benoit-bremaud/cubbies/docs/hardware/calculations/README.md

# Calculations and simulations — cubbies V1

Every figure that chooses or checks a component is recorded here, so that it can be found again
and recomputed. The method is the one proven on V-SEA (owner decision 2026-10-15), scaled to a
hand-wired cube with no PCB.

- [`log.md`](log.md) is the chronological log. **It is append only.** A corrected or superseded
  result goes in a new entry that cites the one it replaces. A merged entry is never edited.
- Each entry `C-NNNN` records:
  - **Purpose**, with its criticality tier;
  - **Method**;
  - **Inputs**, each with its source or marked ASSUMED;
  - **Result**;
  - **Used in**;
  - **Reproduce**, the command that recomputes it;
  - **Based on**, the `main` commit it was computed from.
- A figure used without an entry is not finished. The PR that uses the figure adds the entry.

## Tools

- **Simulation: ngspice 42 benches** in
  [`hardware/electronics/sim/`](../../../hardware/electronics/sim/), one `.cir` per block.
  - Each bench opens with a header stating what it validates, its assumptions, the PASS
    criterion and its run command.
  - Corners are swept with `foreach` / `alterparam`. They are worst-case corners (source ×
    tolerance × load), not Monte Carlo.
  - Where a protection is claimed, the bench adds a negative control (the circuit without it).
  - `sh run.sh` reruns every bench and writes the result tables and SVG plots to `results/`.
- **Arithmetic: `calc.py`** holds the tier-3 lines and needs no dependencies.
- **Second method: `crosscheck.py`** recomputes every Tier 1 bench corner from closed-form or
  piecewise-exact equations and fails on a disagreement (C-0015; owner MCDA 410/500 against a
  second SPICE engine). `run.sh` runs it after the benches.
- **Models: `models.lib`** holds generic models fitted to datasheet worst-case limits. No vendor
  model is redistributed.

R and C nominal values come from `hardware/electronics/cubbies-v1.kicad_sch` through
`sim/schematic.lib`, generated by `schematic_values.py` (as V-SEA does with `spice_block.py`);
`run.sh` refreshes it when kicad-cli is installed. Tolerances, corners, module pull-ups and the
diode, MOSFET and buzzer models stay in each bench.

## Criticality tiers

Each entry states its tier in its Purpose.

| Tier | Applies to | Depth of verification |
|---|---|---|
| 1, critical | Boot or reset correctness, or a datasheet requirement met with less than 2× margin | Theory, then a SPICE bench with full corners, then a second method: closed-form recomputation of every corner (`crosscheck.py`, C-0015; owner MCDA 410/500 over a second SPICE engine). |
| 2, important | A datasheet requirement met with at least 2× margin | Theory plus one SPICE point, or only the corners a decision needs |
| 3, routine | A wide margin | The calculation line alone |

## Status per block

`draft` → `simulated` → `measured` → `approved` (approval at the CDR, `gates.md`).

| Block | Entries | Status |
|---|---|---|
| Current budget, 3V3 LDO | C-0001, C-0013 (supersedes C-0002), C-0012 | calculated from the XC6210 datasheet; θJA bounded 132–400 °C/W, bench temperature at 50 mA on J1 open (CDR) |
| Buzzer stage | C-0003, C-0004, C-0005, C-0015 | simulated, second method agrees on C-0003 |
| Display RESET RC | C-0006, C-0015 | simulated, second method agrees (cold-boot bench open) |
| I2C bus | C-0007, C-0015 | simulated, second method agrees (bench rise-time measurement open) |
| Strapping pins | C-0008, C-0014, C-0015 | simulated, second method agrees (bench boot check open) |
| INMP441, TTP223, SSD1331 interfaces | C-0009, C-0010, C-0011 | calculated |
| V2 battery | — | not started (ADR-0002) |
