benoit-bremaud/cubbies/docs/architecture/traceability-matrix.md

# Traceability matrix — cubbies V1

Proves coverage: every requirement has a use case, a design view, a component and a
verification; nothing is orphaned. This file owns the REQ → design → verification mapping; the
use cases own UC → REQ. Updated at each PDR. Port and module names follow the component diagram
of the first UML study (`diagrams/cube-core/03-component.md`, merged in PR #5).

| Requirement | Use case(s) | Sequence / state | Component (port) | Verification |
|---|---|---|---|---|
| REQ-F-01 eyes | UC3, UC5 | [05a-state-mood-engine](diagrams/cube-core/05a-state-mood-engine.md) (reactions) | eye renderer → `IDisplay` (mood frame, reaction overlay, identity frames; `Timeline`) | golden images (39 frames), blink period test, reaction timing tests (F1b) |
| REQ-F-02 moods | UC3, UC4, UC8 | [05a-state-mood-engine](diagrams/cube-core/05a-state-mood-engine.md) | mood engine (`MoodEngine`); stimulus router (`route`, `effects`) | native mood tests (05a rows), router tests, golden images (F2) |
| REQ-F-03 touch gestures | UC1, UC3, UC6 | [05c-state-gesture-classifier](diagrams/cube-core/05c-state-gesture-classifier.md) | gesture classifier (touch-down + classified gestures) ← `ITouchSource`; eye renderer `TouchDown` overlay held until release | native gesture tests, bench; touch-down next-tick test (F1b) |
| REQ-F-04 sounds | UC3, UC5, UC7 | [05e-state-sound-gate](diagrams/cube-core/05e-state-sound-gate.md) | note tables + `SoundGate` → `IAudio` (notes, level) | native gate tests (F2), bench, ngspice `buzzer-driver.cir` (C-0003..C-0005, ADR-0015 D3) |
| REQ-F-05 volume, silence | UC6 (V1.x ritual step), B1 | [05b-state-sleep-wake](diagrams/cube-core/05b-state-sleep-wake.md), [05e-state-sound-gate](diagrams/cube-core/05e-state-sound-gate.md) | `SoundGate` in `lib/` → `IAudio` (constant `kVolume`, muted Dozing/Asleep) | native gate tests, `RecordingAudio` (F2) |
| REQ-F-06 sleep / wake | UC5 | [05b-state-sleep-wake](diagrams/cube-core/05b-state-sleep-wake.md) | `SleepCycle` ← `IClock` (uptime), reads `MoodEngine` | native sleep tests with injected clock (05b rows, F2) |
| REQ-F-07 identity default + ritual | UC1 | [02a-first-boot](diagrams/identity/02a-sequence-first-boot.md), [02b-adoption](diagrams/identity/02b-sequence-adoption-ritual.md), [05a-invitation](diagrams/identity/05a-state-invitation-window.md), [05b-ritual](diagrams/identity/05b-state-adoption-ritual.md) | identity rules ← `IStorage`, MAC passed by value (`resolveIdentity`, `InvitationWindow`, `AdoptionRitual`, F3); eye renderer identity frames (invitation, ritual, adoption, error) | native tests (`test_native_identity`, `test_native_invitation`, `test_native_ritual`, F3), bench; identity-frame goldens (F1b) |
| REQ-F-08 identity persistence | UC1 | [02a-first-boot](diagrams/identity/02a-sequence-first-boot.md), [05b-ritual](diagrams/identity/05b-state-adoption-ritual.md) | `IStorage` (typed `readU8`/`writeU8`, NVS adapter `NvsStorage`, F5) | native tests (stored/missing/out-of-range, single write, fail closed), bench ([bench-f5](../hardware/bench-f5.md) #8) |
| REQ-F-09 sound reactions | UC4, UC5 | [05d-state-sound-classifier](diagrams/cube-core/05d-state-sound-classifier.md) | sound classifier ← `IMic` (rms + peak per tick) | bench, native threshold tests |
| REQ-F-10 presence, greeting | UC7 | [02-sequence-presence](diagrams/social-presence/02-sequence-presence.md), [06-data-flow](diagrams/social-presence/06-data-flow.md), [05a-neighbour-entry](diagrams/social-presence/05a-state-neighbour-entry.md) | Social protocol ← `IRadio` (pull), `SelfState` per tick (`PresenceCodec`, `SocialProtocol`, F4) | native tests (`test_native_codec` incl. fuzz, `test_native_social` via `LoopbackRadio`, F4), `EspNowRadio` (F5), bench ×2 ([bench-f5](../hardware/bench-f5.md) #9–10) |
| REQ-F-11 contagion | UC8 | [02-sequence-contagion](diagrams/social-group/02-sequence-contagion.md), [05a-state-contagion](diagrams/social-group/05a-state-contagion.md) (PDR validated 2026-10-22, #52) | `SocialProtocol::moodTally()` → `MoodTally` → `pulledMood()`, `MoodEngine::contagion()` (hold, calm, refractory) | native tests: 05a-contagion rows 1–12 (`test_native_contagion`), tally test in `test_native_social` |
| REQ-F-12 chain reaction | UC9 | [02b-sequence-chain](diagrams/social-group/02b-sequence-chain.md), [05b-state-chain](diagrams/social-group/05b-state-chain.md), CHAIN frame in [social-presence/06](diagrams/social-presence/06-data-flow.md) (PDR validated 2026-10-22, #55) | `encodeChain`/`decodeChain`, `ChainReaction` (dedupe, rank delay, relay) owned by `SocialProtocol`, `SocialProtocol::startChain()` | native tests: 05b-chain rows 1–14 (`test_native_chain`), CHAIN codec tests in `test_native_codec` |
| REQ-F-13 rare gag | B2 | **deferred**: `social-group` PDR (mood-engine extension) | mood engine + awake-time accumulator + rate limiter | native rate-limit tests |
| REQ-F-14 choir | UC10 | [02c-sequence-choir](diagrams/social-group/02c-sequence-choir.md), [05c-state-choir](diagrams/social-group/05c-state-choir.md), CHOIR frame in [social-presence/06](diagrams/social-presence/06-data-flow.md) (PDR validated 2026-10-23, #57) | `encodeChoir`/`decodeChoir`, `Choir` (cooldown, anchor, voice rank) owned by `SocialProtocol`, `SocialProtocol::startChoir()`, `SoundGate::play(id, restMs)` with three choir voices | native tests: 05c-choir rows 1–10 (`test_native_choir`), rows 11–12 and the lead rest (`test_native_soundgate`), CHOIR codec tests in `test_native_codec`; bench: drift ≤ 50 ms on two prototypes |
| REQ-F-21 jealousy | B5 | [02e-sequence-jealousy](diagrams/social-group/02e-sequence-jealousy.md), [05e-state-jealousy](diagrams/social-group/05e-state-jealousy.md), [04-class-jealousy](diagrams/social-group/04-class-jealousy.md) (G6a), PET frame in [social-presence/06](diagrams/social-presence/06-data-flow.md) (G6 PDR validated 2026-11-05, #73; G6a PDR validated with its face sheet 2026-11-06, #85, #88) | G6: `SocialProtocol::sendPet()` / `SocialOutput::pet`, `MoodEngine::jealousy(padHeld)` → `MoodEffect::Sulk` (G6, replaced in G6a), `Reaction::Sulk`. G6a face sheet (#88): `Reaction::SideGlance`, `Stare`, `TurnAway`, `Pout`, `PuppyEyes`, `MeToo`, `FakeSleep`. G6a (#90): `PetContext` (`core/Mood.h`), `SocialOutput::petContext`, `Neighbour::presentSince`, `JealousyRepertoire` (`Prng` stream 3), `MoodEngine::jealousy(padHeld, petContext, repertoire)` → `JealousReaction`, `effects(JealousReaction)`, sounds `Hmpf`, `Whimper`, `Chirp` (rank 2) | native tests: 05e sender rows S1–S4 and receiver rows 1–11 and 2b, PET codec (`test_native_jealousy`), Sulk golden in `test_native_eyes`; G6a: receiver rows 1–21 (crescendo, weights, seeded draws), golden face sheet for the seven new reactions (SideGlance, Stare, TurnAway, Pout, PuppyEyes, MeToo, FakeSleep), the Stare blink test and the glance hold tests in `test_native_eyes`, `effects(JealousReaction)` routes, `presentSince` rows of social-presence/05a (all in `test_native_jealousy`), touch-replaces-reaction (row 13) in `test_native_eyes` |
| REQ-F-22 collective sleep | B4 | [02d-sequence-yawn](diagrams/social-group/02d-sequence-yawn.md), [05d-state-yawn](diagrams/social-group/05d-state-yawn.md) (PDR validated 2026-10-23, #59) | `SocialProtocol::moodTally()` → `MoodTally::drowsy`, `MoodEngine::contagion()` (yawn hold, Bored only) | native tests: 05d-yawn rows 1–12 (`test_native_contagion`), drowsy tally test in `test_native_social` |
| REQ-F-15 motion reactions | B3 | tier B (S9) | motion classifier ← `IMotion` (port created at the S9 PDR) | native tests, bench |
| REQ-F-20 expansion module | UC12 | [02-sequence-boot-scan](diagrams/expansion-port/02-sequence-boot-scan.md), [03-component](diagrams/expansion-port/03-component.md) | module registry (lib, at the module PDR) ← `II2cBus` probe; J1 on the I2C bus; rear module bay | native registry tests (module PDR), bench boot with an unknown module, ERC |
| REQ-NF-12 module power | UC12 | — | 3V3 rail through J1 | C-0012 (`calc.py`), bench LDO temperature with 50 mA on J1 |
| REQ-NF-01..11 | — | — | see [verification-plan.md](verification-plan.md) | per method |

PDR `cube-core` passed on 2026-10-14 (ADR-0013). PDR `social-group` (G2 part, REQ-F-11) passed on
2026-10-22 (issue #52). G3 part (REQ-F-12) passed on 2026-10-22 (issue #55). G4 part (REQ-F-14) passed on 2026-10-23 (issue #57). G5 part (REQ-F-22, numbered REQ-F-20 until issue #87 removed the duplicate) passed on 2026-10-23 (issue #59). G6 part (REQ-F-21) passed on 2026-11-05 (issue #73). Still deferred to the `social-group` PDR: REQ-F-13. Open until then: double tap cycling backwards in the ritual (with the palette size).
