benoit-bremaud/cubbies/docs/architecture/diagrams/cube-core/05a-state-mood-engine.md

# State diagram — cube-core — mood engine

> **Frame**: `stm — Mood engine`
> **Feature**: `cube-core` — backlog items S2, S3, S7, G2 (hook only) in [docs/roadmap.md](../../../roadmap.md)
> **Related ADRs**: ADR-0001 (solo layer is the daily use), ADR-0006 (eyes drift against burn-in), ADR-0013 (timings, touch-down, calls never annoy)
> **Module**: `Mood engine` in [03-component.md](03-component.md)

## Context

This diagram answers "what lifecycle does the mood go through, and what moves it?". The mood is
a single discrete state among the five of S2. Transitions come from stimuli delivered by the
Stimulus router (gestures, sounds, `NewcomerSeen` from the social protocol) or from timers fed by
the injected clock. The eyes rendering of each mood and the cross-fade between two moods are
rendering concerns (Eyes renderer), not states. Sleep is a separate, orthogonal machine
([05b-state-sleep-wake.md](05b-state-sleep-wake.md)): the mood engine is paused while the cube is
not Awake, and every wake restarts it in Curious.

## Diagram

```mermaid
stateDiagram-v2
  [*] --> Curious

  Curious --> Happy: tap or double tap
  Curious --> Bored: no stimulus for T_bored
  Curious --> Annoyed: loud (sustained)

  Happy --> Curious: calm for T_settle
  Happy --> Happy: long stroke (purr, eyes close)
  Happy --> Annoyed: loud (sustained)

  Bored --> Curious: any stimulus
  Bored --> Tired: no stimulus for T_tired

  Tired --> Curious: any stimulus
  Tired --> Tired: yawn every T_yawn

  Annoyed --> Curious: calm for T_calm
  Annoyed --> Happy: long stroke

  note right of Curious
    Default resting mood.
    Eyes look around and blink,
    static frames drift one pixel
    against OLED burn-in.
  end note

  note right of Tired
    Only mood from which the sleep
    machine enters Dozing.
  end note
```

## Transition table (source of the firmware constants)

| From | Trigger | To | Side effect |
|---|---|----|---|
| — | machine entered at boot, and re-entered at every wake | Curious | none (the wake-up melody is owned by 05b Waking and by the boot sequence 02a) |
| Curious | tap, double tap | Happy | surprise or joy beep |
| Curious | idle ≥ T_bored | Bored | none |
| Curious, Happy | loud (sustained, never a voice or a clap) | Annoyed | grumpy beep |
| Happy | long stroke | Happy | purr, eyes close while touched |
| Happy | calm ≥ T_settle | Curious | none |
| Bored | any stimulus | Curious | none |
| Bored | idle ≥ T_tired | Tired | first yawn |
| Tired | every T_yawn | Tired | yawn (sound + eyes) |
| Tired | any stimulus (gesture, voice, clap, NewcomerSeen) | Curious | none — a cube being petted or spoken to never dozes off |
| Annoyed | calm ≥ T_calm | Curious | none |
| Annoyed | long stroke | Happy | purr |
| any | touch-down (pressed edge) | unchanged | eyes widen within one tick (REQ-NF-01); the classified gesture follows |
| any | voice, clap (a call, UC4) | unchanged unless Bored or Tired | eyes widen and look up |
| any (Awake) | NewcomerSeen (UC7 greeting) | unchanged, except Bored and Tired → Curious (row above) | glance toward nothing in particular + hello beep through the Sound gate, in every mood (owner decision 2026-10-15, brick F2) |

**Stimuli not listed for a state leave the mood unchanged.** They still produce the reaction
animation and beep of S3 (a tap in Happy is a surprise, a stroke in Curious is a purr), which is
how UC3 guarantees a visible reaction in every mood. "Any stimulus" in Bored means every gesture,
sound or `NewcomerSeen`; `released` (end of a medium press or a stroke) is a gesture, so a medium
press on a Bored or Tired cube brings it back to Curious (owner decision 2026-10-15, brick F2).
"Calm" means no gesture and no sound above the voice threshold.

Durations are constants of the Mood engine, set in one header; tests advance the injected clock
to exercise them. Starting values (ADR-0013, chained with 05b so that the cube dozes 10 min and
sleeps 30 min after the last attention, FS5): T_settle 10 s, T_calm 20 s, T_bored 3 min,
T_tired 5 min, T_yawn 45 s. These are tuning parameters, not decisions, and change without an
ADR.

## Mood encoding (shared with the presence frame)

| Value | Mood |
|---|---|
| 0 | Curious |
| 1 | Happy |
| 2 | Bored |
| 3 | Tired |
| 4 | Annoyed |
| 5 | Asleep (sleep machine state, not a mood — see 05b) |

## Notes

- **Deterministic and replayable**: no transition reads `millis()` or `random()` directly, so a
  native test can script a stimulus timeline and assert the mood sequence.
- **Why discrete states rather than a valence/arousal vector**: five moods map one-to-one to the
  eye animations of S2 and to the beeps of S4, and the roadmap's social behaviours (G2 contagious
  mood) only need to publish one mood byte in the presence frame. A continuous model is deferred
  until a behaviour needs it. Owner decision, validated 2026-10-14.
- **Wake always restarts in Curious** (owner decision, validated 2026-10-14): resuming in Tired
  would send a just-woken cube back to Dozing two minutes later.
- **Shake is not a V1 trigger**: it needs the IMU (P2, backlog S9, tier B). When S9 enters, it
  adds "shake → Annoyed" from Curious and Happy to this table, nothing else changes.
- **G2 hook**: `NewcomerSeen` is already a stimulus in V1 (greeting). Contagious mood (G2,
  REQ-F-11) will add a transition "neighbour majority mood for T_contagion → that mood" at the
  `social-group` PDR, not a new machine. That transition and its guards are specified in
  [social-group/05a-state-contagion.md](../social-group/05a-state-contagion.md) (G2, issue #52).
- **Rare gag (REQ-F-13)**: an extension of this machine (an awake-time accumulator and a rate
  limiter, output through the Sound gate), deferred to the `social-group` PDR with G2/G3.
- **Not in this diagram**: the long-term "sulks when ignored for two days" (S10) needs persisted
  counters and will extend Bored when it enters a version.
