benoit-bremaud/cubbies/docs/architecture/qa/2026-10-19-case-parts.png

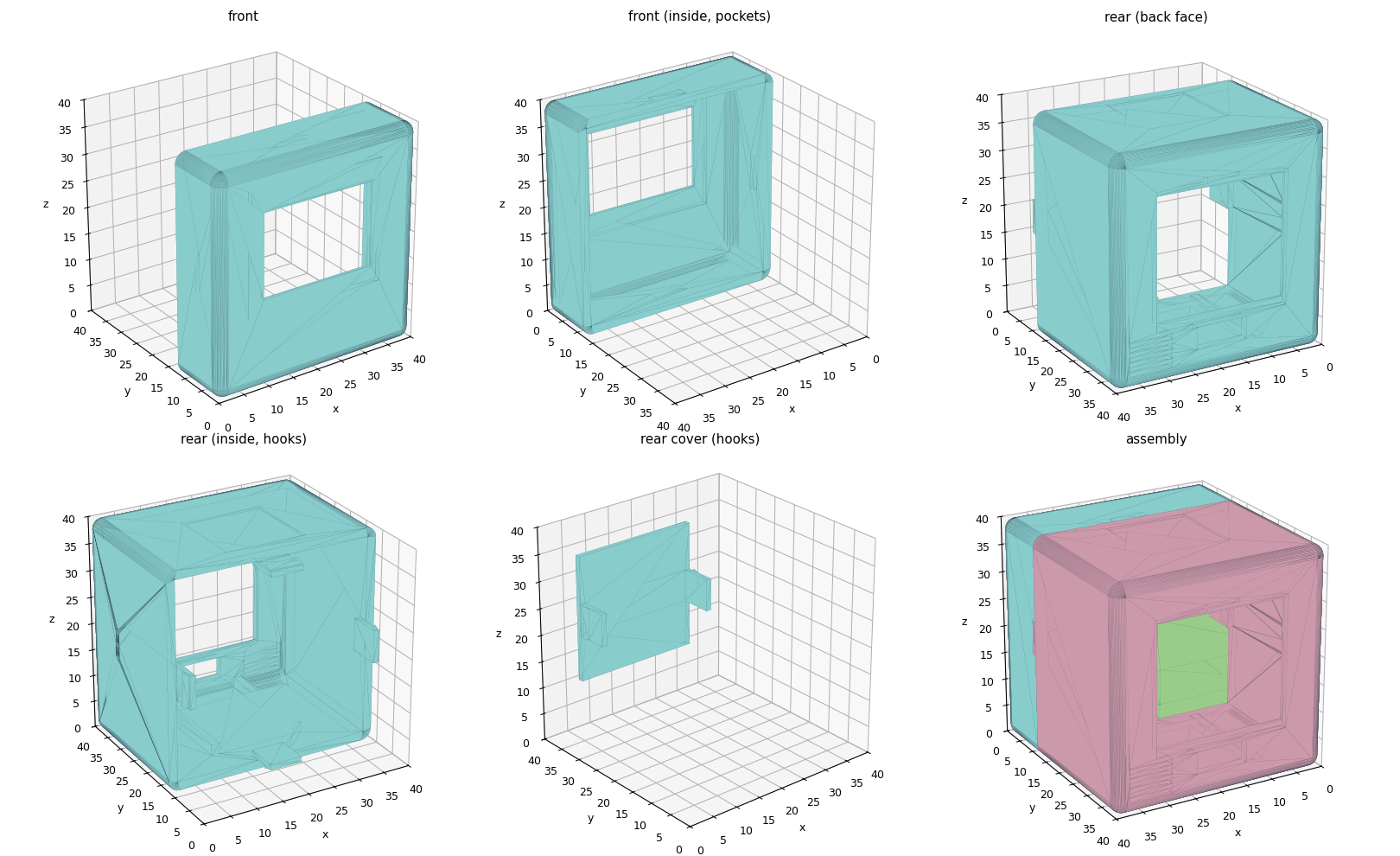
docs/architecture/qa/2026-10-19-case-parts.png
