benoit-bremaud/cubbies/hardware/case/export/cubbies.step

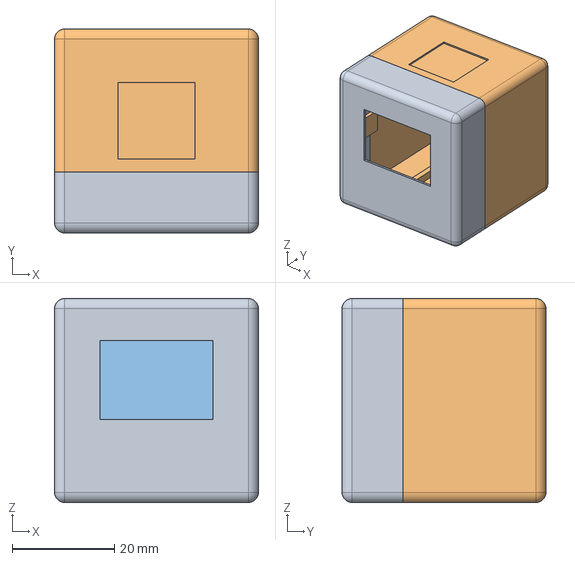
[picture p2: CAD file, 2026-10-19]
hardware/case/export/cubbies.step
40.0 x 40.0 x 40.0 mm
