benoit-bremaud/cubbies/hardware/case/export/print/cubbies-rear.stl

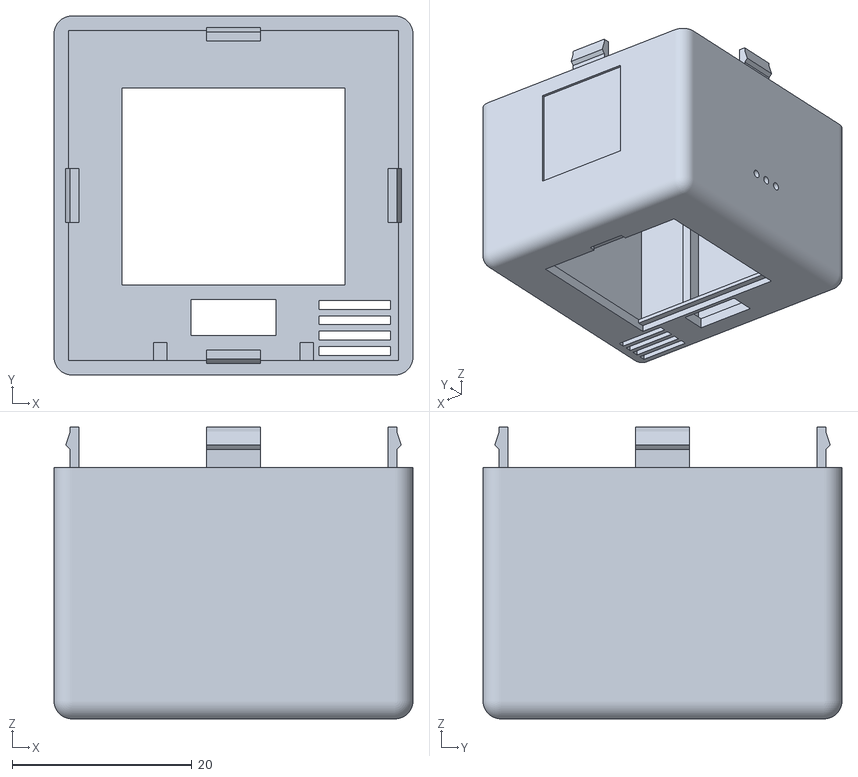
[picture p3: CAD file, 2026-10-19]
hardware/case/export/print/cubbies-rear.stl
40.0 x 40.0 x 32.5
