benoit-bremaud/cubbies/hardware/case/export/print/coupon-front.stl

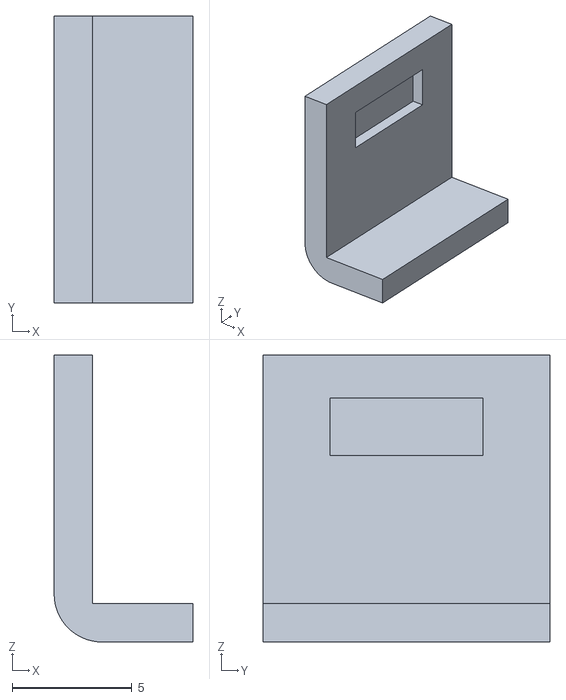
[picture p4: CAD file, 2026-10-19]
hardware/case/export/print/coupon-front.stl
5.80 x 12.0 x 12.0
