benoit-bremaud/cubbies/hardware/case/export/print/coupon-rear.stl

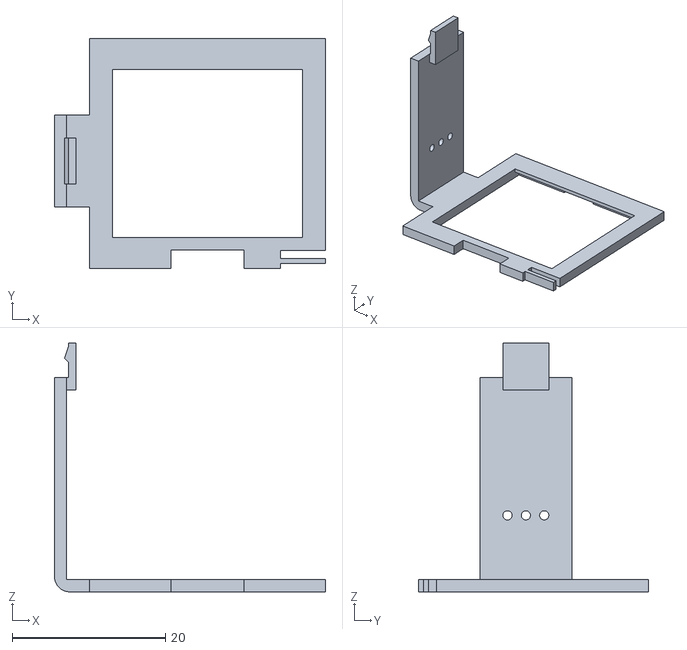
[picture p5: CAD file, 2026-10-19]
hardware/case/export/print/coupon-rear.stl
35.4 x 30.0 x 32.5
