benoit-bremaud/cubbies/hardware/case/export/print/cubbies-plate.3mf

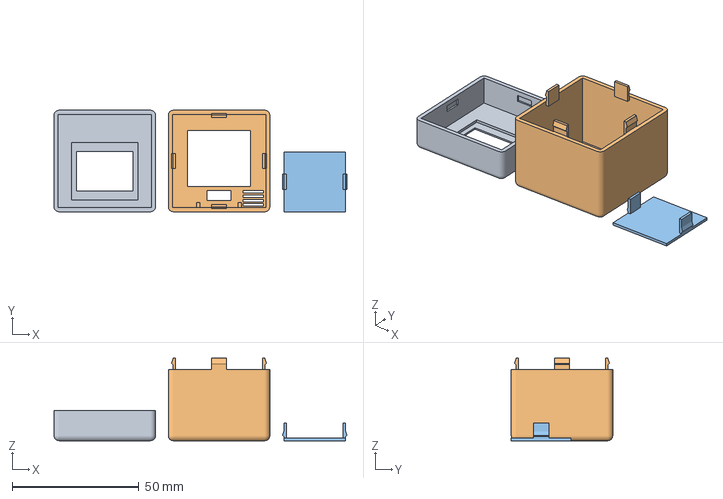
[picture p6: CAD file, 2026-10-19]
hardware/case/export/print/cubbies-plate.3mf
115.4 x 40.0 x 32.5 mm
