benoit-bremaud/cubbies/hardware/case/export/print/coupon-plate.3mf

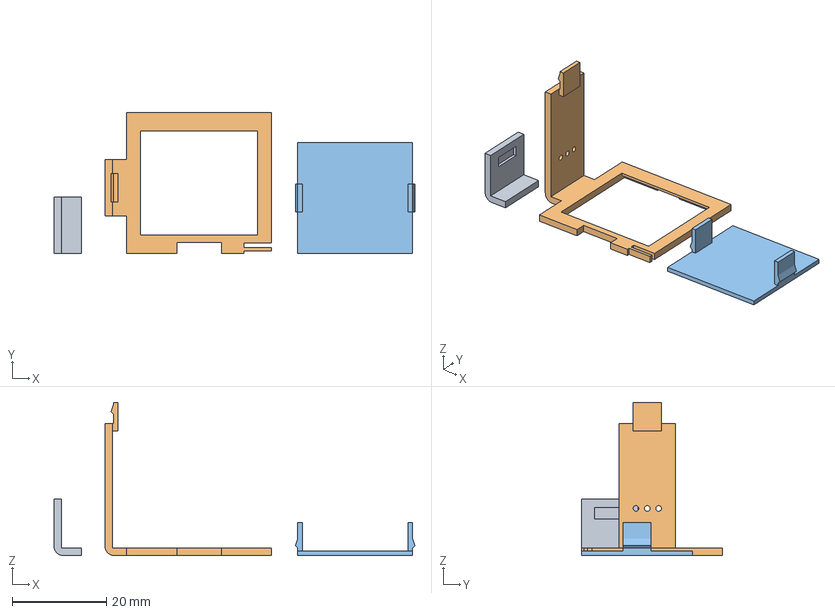
[picture p7: CAD file, 2026-10-19]
hardware/case/export/print/coupon-plate.3mf
76.6 x 30.0 x 32.5 mm
