benoit-bremaud/cubbies/hardware/case/export/print/cubbies-front.stl

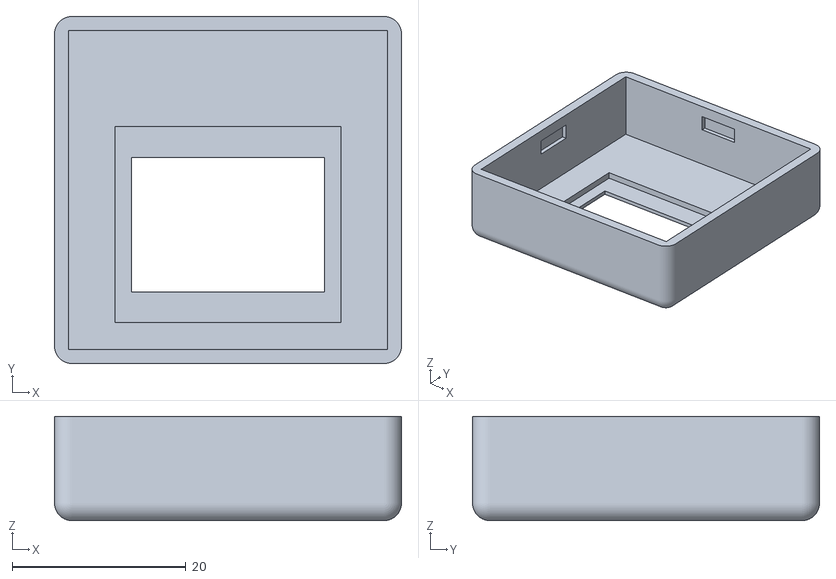
[picture p8: CAD file, 2026-10-19]
hardware/case/export/print/cubbies-front.stl
40.0 x 40.0 x 12.0
