benoit-bremaud/cubbies/hardware/case/export/print/cubbies-rear-cover.stl

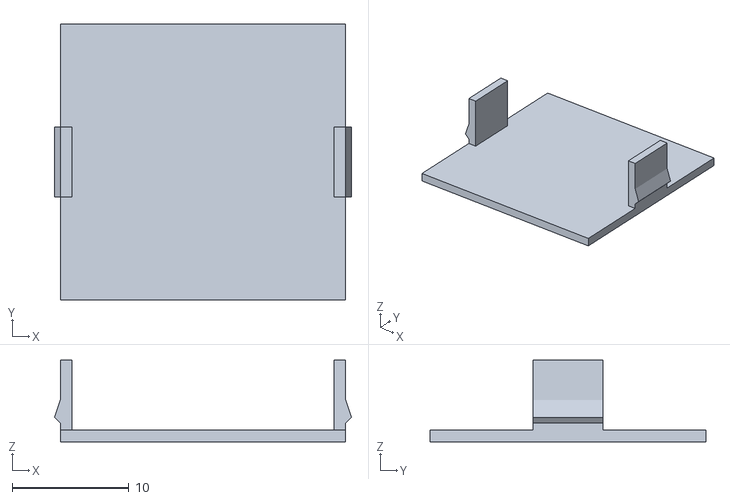
[picture p9: CAD file, 2026-10-19]
hardware/case/export/print/cubbies-rear-cover.stl
25.4 x 23.6 x 7.00
