benoit-bremaud/cubbies/(list of files, cad)

Other CAD files:
hardware/case/export/cubbies-front.stl
hardware/case/export/cubbies-rear-cover.stl
hardware/case/export/cubbies-rear.stl
hardware/case/export/cubbies.FCStd
