benoit-bremaud/cubbies/PROJECT_LOG.md

# Project Log — cubbies

Reverse-chronological operational logbook (most recent first). It complements `git log` with the
human context: what was done, why, and by which PR.

---

## 2026-11-13

### Nightly toolchain drift: typos 1.52.2 (issue #101) — **PR #102** (848a4c1)

- The 2026-11-13 nightly failed at the toolchain-drift step: `mise outdated --bump` reported typos
  1.52.0 with 1.52.2 available. Bumped `mise.toml` and refreshed `mise.lock`; `just nightly`,
  `just check` and `just gate` green, adversarial review gate open.
- LovyanGFX 1.3.0 not bumped: `pio pkg outdated` reports it informationally only (does not fail
  the nightly) and ADR-0014 pins 1.2.33; a bump needs its own issue and ADR update.

## 2026-11-07

### Local-first CI, no GitHub workflow (issue #99) — **PR #100** (8b2a814)

- Owner decision of the day for every project (agents-skills#210 model A, wave 0 bis #259): the
  checks run on the laptop, GitHub Actions keeps only a production deploy on a signed tag, and
  cubbies deploys nothing. The five workflows (`ci`, `codeql`, `dependency-review`, `gitleaks`,
  `scorecard`) and `dependabot.yml` are removed; `.github/` holds `allowed_signers` only. Since
  2026-10-01 they had run 589 times for 812 job minutes (free, public repository).
- ADR-0019 records the two MCDA decisions: Scorecard removed (385/500 vs 330 to keep it weekly
  and 285 as it was), no tag-triggered `prod.yml` (470/500 vs 325 for a later local `just
  release` and 280 for a workflow publishing the `.bin`).
- Local CI per skill `local-ci`: `justfile` (fast / check / gate / nightly, build, sonar, merge),
  `mise.toml` + `mise.lock`, `lefthook.yml`, `typos.toml`, `scripts/attest.sh`,
  `check-commit-msg.sh`, `test-attest.sh` (23 cases), `test-local-ci.sh` (73 cases), systemd user
  timer `cubbies-nightly` at 04:50. `tools/sonar-scan.sh` now passes extra scanner options so
  `just sonar` waits for the quality gate.
- Gotcha: `~/.local/bin/pio` (pipx) is broken; PlatformIO runs as `uvx --from platformio==6.2.0
  pio`. The pioarduino platform points `SSL_CERT_FILE` at the penv certifi bundle before its
  `uv pip install --upgrade`, so behind Aikido every board build failed with
  `invalid peer certificate: UnknownIssuer`; `scripts/pio-trust-local-ca.sh` (run by `just
  build`) appends the locally installed CAs to that bundle. `certifi-system-store` was tried and
  reverted (needs `pkg_resources`, absent from the penv).
- Gotcha: `~/.platformio/packages` is shared by every project on the machine, one directory per
  package name. V-SEA's official `espressif32@6.12.0` pins `toolchain-riscv32-esp` 8.4.0 where
  pioarduino pins 14.2.0, so each build of one project reinstalled the toolchain of the other and
  `just check` failed twice with `riscv32-esp-elf-g++: not found` or `Directory not empty`.
  the `justfile` now exports `PLATFORMIO_PACKAGES_DIR=~/.platformio/packages-cubbies` (5 GB,
  first build 200 s); the platform, the penv and the download cache stay shared.
- Measured 2026-10-01 → 2026-11-07 from the jobs API (table on #99): 589 runs, 812 job minutes
  (CI 372, CodeQL 357, Scorecard 30, Dependabot 22, Gitleaks 20, dependency review 11).
- `just check` timings on this machine: native tests 373 cases in 15–37 s, both board builds
  18–87 s warm, lint 5 s, Semgrep 4 s, gitleaks under 1 s; the whole tier 87–174 s from a clean
  environment (budget 3 min).

### Chain frame stamped before the origin's trigger meets the cooldown (issue #95) — **PR #98** (6b48df9)

- `startChain()` runs before `tick()` in `main.cpp`, so a CHAIN frame queued for another event
  was heard stamped `T - 1` after the origin set its last reaction to `T`: `ageMs(T - 1, T)` is
  ~2^32 ms, the frame slipped past the row 12 cooldown and the origin reacted twice. The
  cooldown is now a symmetric window around the last reaction (MCDA 480/500, vs 375 for a
  signed age, which locks a cube idle for over 24.8 days, and 340 for judging it in `tick()`
  like Choir, which would hold the pending slot against row 10).
- The trigger also drops an event heard one tick before it (same double Joy, found by the
  adversarial review), as `Choir::start` already refuses with one pending.
- New native tests: a frame stamped 1 ms before `start()` (red first, ADR-0014), the window's
  bound and wrap, and the pending event dropped. 05b row 12 and its age note amended (window on
  both sides of the last fire).

### Frame receive time clamped to the tick (issue #91) — **PR #96** (a572b13)

- `SocialProtocol::tick()` read `now` before draining the radio, while `EspNowRadio` stamps each
  frame in the Wi-Fi callback: a frame stamped `now + 1` aged its sender by ~2^32 ms in
  `expire()`, so the entry went Absent then Free in one pass and was greeted again (forbidden by
  social-presence 05a). The drain now clamps a later receive time to `now` inside `lib/` (MCDA
  460/500, vs 440 for clamp plus reading `now` after the drain, 350 for the reorder alone).
- New native test with a frame stamped 1 ms ahead (red first, ADR-0014); the misleading claim in
  `ChainReaction.h` that `ageMs()` tolerates it is corrected. Diagram 05a unchanged.

### Requirement ids, diagram index and ruff format (issues #87, #80) — **PR #93** (8d4ad70)

- REQ-F-20 was used twice. Collective sleep becomes REQ-F-22; the expansion module, added first
  (ADR-0016), keeps REQ-F-20, so no accepted ADR changes (MCDA 435/500 vs 215). Older log
  entries and review reports keep the old number as history.
- The README diagram table now lists every view (social-group, expansion-port, identity 05a/05b,
  social-presence 05a).
- `ruff format` applied to `golden_sheet.py` and `calc.py`; CI gains a `python` job running
  `ruff check` and `ruff format --check` with ruff 0.14.0 (MCDA 450/500 vs 210).

## 2026-11-06

### G6a jealousy repertoire (issue #90) — **PR #92** (07888bf)

- The G6 single Sulk becomes the 05e two-step crescendo: the first PET under the guards is
  noticed (a silent step-1 reaction, no cooldown or budget entry), a second one within T_notice
  (60 s) with no owner attention since draws a step-2 reaction under the G6 cooldown and budget.
  The mood is unchanged (D3'); `MoodEffect::Sulk` is gone, `jealousy()` returns a
  `JealousReaction`.
- `JealousyRepertoire` (lib) holds the 05e weight tables, the no-repeat memory per step and its
  own `Prng(seed, 3)`, built in `Seeded` after Wi-Fi (ADR-0013). The engine computes the
  contexts (Bored, Crowd, Newcomer / Friend, Neglected from a new `lastOwnerMs_`, Weary from the
  step-2 ring now kept up to 30 min).
- Input: `PetContext` in `core/Mood.h`, filled by the Social protocol from the first PET of the
  tick; `Neighbour::presentSince` (set on store and re-greet, kept within T_regreet, bounded at
  T_friend so it never wraps).
- `effects(JealousReaction)` in the Stimulus router; three rank-2 placeholder sounds (Hmpf,
  Whimper, Chirp) through the Sound gate; `main.cpp` only applies the route.
- TDD: every 05e row as a failing native test first (6afcb7c), then the code.

### G6a face sheet of the seven jealousy reactions (issue #88) — **PR #89** (244d887)

- Seven new `Reaction` values in the eyes renderer, 3 s each (T_react, 05e Repertoire): step 1
  SideGlance, Stare, TurnAway (look offsets, silent), step 2 Pout, PuppyEyes, MeToo, FakeSleep.
  Sulk keeps its 900 ms and its golden is byte-identical; no other golden changed.
- The renderer now holds idle glances while a timed reaction plays (the due glance fires once it
  ends); held TouchDown and Purr keep them so a long stroke never freezes the frame (FS1). Stare draws its own three fast blinks in the last 600 ms (owner choice 440/500: inside
  `applyReaction`, `Timeline` untouched, vs a repeating `Timeline` mode 330), pinned by a test.
- TDD: tests first (durations, Stare blinks, glance hold, nine goldens: MeToo and FakeSleep have
  two key frames). Owner reviewed the sheet twice: round 1 accepted three retouches (470/500:
  SideGlance lids lowered so it no longer matches `greet-1`, Stare 2 px taller, Pout inner
  corners low), round 2 validated (450/500). No repertoire logic, mood or protocol change.
- 05e records D8 (Stare blinks), D9 (glance hold) and the retouches; the traceability matrix
  marks the G6a PDR validated with this sheet.
- Adversarial review round 1: Must 3 (glances held during TouchDown and Purr froze the frame,
  05e and the matrix still described a `Timeline` case, the glance test passed without the hold)
  and Should 4 (untested blink cut and side rules, stale comments and counts) fixed; both
  mutants now fail their test.
- Codex review on PR #89 (P2): a glance could redraw the current gaze, so a held stroke could
  still freeze 10 s (seed 174349); a repeated draw is now nudged one pixel (97d3a18).

### G6a jealousy repertoire PDR (issue #85) — **PR #86** (10f5c3c)

- PR #76 (G6a design written before G6 merged) superseded: owner chose a fresh branch from main
  porting only its reusable parts (MCDA 415/500 vs merging main into #76 255; adversarial check:
  about 40 % of its 05e survived, the rest contradicted G6's validated D2/D3, REQ-F-22 clashed
  with REQ-F-21, and a clean merge hid a duplicate B5). Issue #73 being closed by #75, the work
  moved to the new issue #85.
- Owner decision D3' (2026-11-05): D3 kept, every reaction leaves the mood unchanged, 440/500 vs
  an Annoyed top step under ADR-0018 330 and Annoyed only when Neglected 300; the Annoyed step
  goes to G6b, so G6a does not depend on ADR-0018 (still Proposed). #76's G2 echo guard is
  dropped with it (nothing spreads when the mood never changes).
- 05e: a silent step-1 glance (SideGlance, Stare, TurnAway), then within T_notice 60 s a step-2
  reaction (Pout, PuppyEyes, MeToo, FakeSleep, Sulk) drawn from context weights (Bored, Crowd,
  Newcomer, Friend, Neglected, Weary) by a `JealousyRepertoire` owning `Prng` stream 3; G6 sender
  rules, guards, T_calm_jealous 6 s, cooldown 60 s and budget 4 per 10 min kept and charged to
  step 2 only. REQ-F-21 and B5 amended in place; roadmap gains G6a and G6b.
- Adversarial review: round 1 Must 5 Should 13 (owner attention after the notice, Sulk keeps
  its 900 ms, engine-computed Weary and Neglected, draw rule, wrap-safe `presentSince` rows in
  social-presence/05a, lib `effects(JealousReaction)`, new class view 04-class-jealousy, ADR-0018
  Context and Consequences retargeted from PR #76 to G6b, misdated log heading) fixed; round 2
  Must 1 (02e Mermaid parse error) and the Weary ring clearing fixed. The G6a PDR passes only
  once the face sheet PR is accepted.

## 2026-11-05

### ADR-0018 bounded one-shot social events (issue #73) — **PR #77** (8177cde)

- Owner decision D5 of the G6a study (PR #76): a single frame may change the mood through a
  one-shot social event under seven bounds (allowlist, present sender with matching index,
  cooldown ≥ 60 s, Awake only, ADR-0012 effect envelope, a stroke overrides, no G2 echo).
  Re-scored in the ADR after review (risk 4 for A): 410/500 vs per-PDR argument 340, held signal
  305. Amends only ADR-0012's "nudge only" consequence; G2/G5 keep their holds; CHAIN and CHOIR
  (no mood change) stay outside it. Adversarial round 1: 4 Must (sums, false CHAIN/CHOIR claim,
  restated relay rule, "once per minute" claim) fixed.

### SonarQube coverage measures the case script (issue #53 follow-up) — **PR #84** (93c5651)

- #81 closed #53 while this branch was in review; owner chose (MCDA 420/500 vs a G6-SHA-only PR
  300, closing 225) to keep this branch as a delta on top of #81.
- Coverage tooling, option A by MCDA (395/500 vs case excluded 375, plus gcovr 205): the
  owner's choice. `tools/sonar-scan.sh` replaces `hardware/electronics/sim/coverage.sh` and
  measures the case script inside the FreeCAD python (check-only), so `cubbies_case.py` leaves
  `sonar.coverage.exclusions`. The Community server has no C/C++ analyser, so no gcov report.
- `walls_in_place` and a module-level `solid` also leave `run_checks` (on top of #81's
  `coupon_ok`); the spaced-unit regex anchors on a digit; a linear-time parser test (red on the
  old `fullmatch`, ~4.5 s on 20000 digits). Regenerated STLs and 3MF members byte-identical.
- Adversarial review round 1: Must 1 (freecadcmd exits 0 on an exception; the wrapper exits 1)
  · Should 3 (sim logs shown, CLAUDE.md layout, run.sh FAIL noise filed as #82) · Nice 5
  (fixed; freecadcmd exit code on plain regeneration filed as #83). Round 2: Must 1 (stale
  parallel coverage files merged; removed with rm) · Should 1 (`CASE-COV-OK` sentinel) · Nice 2.
  Round 3: gate open. Round 4 (merge of main): Should 2 (branch coverage restored with
  `--branch` on both sides as in #81; #82 kept although #81 found nothing to change, because the
  negative-control line still reads as a failure in the gate output) · Nice 2 (stale
  `coverage.xml` removed before measuring; this entry completed). Commit 2bfa8b3's subject
  wrongly claims S8786.
- Merge of main: `coverage.sh` deleted, `coverage` pinned to 7.17.1 as in #81.
- Gate: SonarQube OK (new coverage 86.3 % with branches, 0 new violations), 18 case checks PASS, 328 native
  tests, both boards, benches, ERC 0, ruff, gitleaks, actionlint.

### SonarQube gate green (issue #53) — **PR #81** (0586028)

- Gate was red on main: new coverage 0 % (no Python report) and 2 issues. Fixed S3776
  (`run_checks` complexity 16 → `coupon_ok` extracted; the 18 FreeCAD checks still PASS) and
  S8786 (the `si_value` regex backtracked between `\d+` and `\d*`; decimals now only after a
  prefix).
- `sonar-project.properties` and `hardware/electronics/sim/coverage.sh`: coverage of the test
  scripts plus the real bench scripts, 96.1 %; `cubbies_case.py` (FreeCAD only, prints its own
  18 PASS lines) and `golden_sheet.py` (manual review tool) excluded from coverage. `coverage` pinned
  to 7.17.1. Local scan on the rebased head: gate OK (new coverage 96.1 %, 0 issues; the
  local SonarQube analyses Python only). Gate: 328 native tests, benches PASS, ruff, gitleaks.
- Adversarial review round 1: Must 1 (stale base, PROJECT_LOG conflict with #75, fixed by
  rebase) · Should 2 (unpinned coverage, stale coverage.xml on failure: fixed) · Nice 2 (regex
  cases added to the test, script failure output shown: fixed).
- The "FAIL C-0015" line that `run.sh` prints comes from the negative control in
  `test_crosscheck.py`; `run.sh` exits 0 correctly, nothing to change.

### G6 jealousy (issue #73)

- Dependabot PRs #67, #66, #50, #71 merged first (codeql-action grouped); G6 picked by MCDA
  (415/500 vs #53 SonarQube 380, G12 clap wave 365, S10 340, S9 265).
- PDR `social-group` (G6 part) validated by the owner: REQ-F-21 (REQ-F-20 is used twice on
  main, follow-up), behaviour B5, `diagrams/social-group/` 05e rows and 02e sequence, PET type
  0x04 in social-presence/06, traceability. Scored options: D1 new PET frame 405/500 (vs CHOIR
  receipt 275, PRESENCE mood byte 265); D2 a stroke starts the choir when allowed, else PET
  450/500; D3 transient sulk, mood unchanged, 445/500 (vs entering Annoyed 355). Calm 6 s,
  cooldown 60 s, budget 4 per 10 min (ADR-0012), sender cooldown 10 s.
- TDD (red commit first): `encodePet`/`decodePet`, `SocialProtocol::sendPet()` and
  `SocialOutput::pet`, `MoodEngine::jealousy()`, `Reaction::Sulk` (golden `sulk`),
  `effects(MoodEffect::Sulk)`; `main.cpp` wiring.
- Adversarial review round 1: Must 1 (S3 test passed for the wrong reason, fixed, mutant now
  killed) · Should 5 (fixed) · Nice 6 (5 fixed; the 6th, a sulk mid-song, became 05e row 11 by
  owner decision, 430/500 vs 365). Verify rounds: 2 Nice fixed, then the row 11 diagrams fixed.
  Gate: 327 native tests, both boards, benches PASS, ERC 0, ruff, gitleaks, actionlint clean.
- Codex P2 on PR #75: a long hold stopped refreshing the calm, so a held cube could sulk;
  fixed by 05e row 2b, `jealousy(padHeld)` fed with `holdMs() > 0`.
- Owner request: a desktop fleet simulator, filed as #74 (roadmap T11), queued after G6.
- Merged as PR #75 (`13aff3c`) with an owner SonarQube waiver (MCDA 450/500): the gate was red
  only from pre-existing debt outside the diff, fixed next in #53.

## 2026-10-23

### Voice and AI research note (issue #61) — **PR #62**

- Voice study picked by MCDA (405/500 vs G6 jealousy 385, S9 275).
- Owner direction by MCDA (identity 30, feasibility 25, privacy 20, wow 15, BOM 10): group
  effect — a human sound triggers the group, no words — 460/500, vs prosody 395, S3 ear cube 360.
- `docs/research/voice-and-ai.md` (ESP-SR targets S3/P4 not C3, TFLM + ESP-NN on C3, cloud via
  mother cube, GDPR of an office mic, BOM/power, MicroDuck fleet-simulator ideas), ADR-0017
  Proposed, roadmap G12 clap wave. Context7 out of quota: library facts from the vendors' READMEs.
- Also fixed the G5 entry (PR #60). No cubbies GitHub Project exists; issue left off a kanban.

### G5 collective sleep (issue #59) — **PR #60** (9d3045f)

- G5 picked by MCDA (465/500 vs G6 jealousy 415, voice study 375, S9 295).
- PDR `social-group` (G5 part) validated by the owner: REQ-F-20, behaviour B4 (system-initiated,
  outcome of UC5 + UC8), `diagrams/social-group/` 05d yawn rows and 02d sequence, traceability.
  Scored options (effect 30, owner safety 25, simplicity 25, robustness 20): D1 only a Bored cube
  catches the yawn 440/500; D2 it enters Tired and yawns, then the usual sleep cycle 470/500.
  No new frame: PRESENCE mood byte 3 (Tired/dozing) or 5 (asleep) = drowsy; T_contagion 6 s reused.
- TDD (red commit first): `MoodTally::drowsy`, `MoodEngine::contagion()` yawn hold evaluated
  before G2. No `main.cpp` change (already wired by G2).
- review-local: Must 1 doc (fixed) · Should 3 (fixed) · Nice 6 (2 fixed). Gate: 305 native tests,
  both boards, benches PASS, ERC 0, ruff, gitleaks clean; SonarQube red only for #53.

### G4 synchronised choir (issue #57) — **PR #58** (31b40d0)

- Project resumed after the 2026-10-22 pause; G4 picked by MCDA (410/500 vs voice study 390, S8 330).
- PDR `social-group` (G4 part) validated by the owner: UC10 with extensions,
  `diagrams/social-group/` 05c choir rows and 02c sequence, CHOIR type 0x03 in social-presence/06,
  traceability, FS8 drift row in the verification plan. Scored options (effect 30, robustness 25,
  simplicity 25, fit 20): D1 stroke with a present neighbour 430/500; D2 one-shot start anchored
  on the receive time + lead rest in the Sound gate 475/500; D3 voice = MAC rank mod 3 445/500;
  dossier 445/500. kLeadMs 500, T_choir 60 s, three voices at rank 3 (raised from 2 after Codex P2: a Grumpy must not block the choir), never relayed.
- TDD (red commit first): `encodeChoir`/`decodeChoir`, `Choir`, `SocialProtocol::startChoir()`,
  `SoundGate::play(id, restMs)` and three placeholder voices; `main.cpp` wiring.
- review-local: Must 0 · Should 19 (fixed) · Nice 8 (4 fixed, 4 documented). Fixed bug: a CHOIR
  frame received before the last start and drained a tick later passed the 60 s cooldown.
- Gate: 292 native tests, both board builds, benches PASS, gitleaks clean, new lib code 100 %
  lines. SonarQube red on main outside the diff (#53), owner waiver. FS8 drift bench pending.

## 2026-10-22

### G3 chain reaction (issue #55) — **PR #56** (6a2807b)

- PDR `social-group` (G3 part) validated by the owner: UC9 with extensions,
  `diagrams/social-group/` 05b chain rows and 02b sequence, CHAIN type in social-presence/06,
  traceability. Scored options (effect 30, robustness 25, simplicity 25, fit 20): D1 double tap
  with a present neighbour 425/500; D2 MAC-rank delay 300 ms × (1 + rank) 430/500; D3 8-byte
  type 0x02 frame, (palette, 8-bit id) key, hop ≤ 3, protocol v1 kept 445/500; D4 `ChainReaction`
  owned by the Social protocol 420/500. T_trigger 10 s, T_cooldown 5 s, T_seen 30 s (8 keys).
- TDD (red commit first): `encodeChain`/`decodeChain`, `ChainReaction`, `SocialProtocol::startChain()`,
  `routeChain()`; `main.cpp` reads the MAC before building the Social protocol.
- review-local: Must 0 · Should 13 (fixed) · Nice 9 (documented). Codex P1 (first hop 600 ms when
  the origin has the lower MAC) fixed: the frame sender is not ranked; P2 declined (row 12 caps
  received events, the owner trigger has its own 10 s cooldown).
- Gate: 262 native tests, both board builds, benches PASS, gitleaks clean, new lib code 100 %
  lines. SonarQube red on main outside the diff (#53), as for G2.

### G2 contagious mood (issue #52) — **PR #54**

- PDR `social-group` (G2 part) validated by the owner: UC8 with extensions,
  `diagrams/social-group/` (05a contagion rows, 02 sequence), traceability. Scored options
  (effect 30, stability 25, simplicity 25, robustness 20): D1 neighbours-only plurality, ties
  Happy > Annoyed > Curious > Bored, 60 s refractory 430/500 (365 self-voting, 275 Prng voter);
  D2 every mood but Tired 450/500; D3 mood-engine extension fed a `MoodTally` value 450/500.
  T_contagion 6 s, T_refractory 60 s.
- TDD (red commit first): `MoodTally` + `pulledMood()`, `MoodEngine::contagion()` and
  `touchDown()`, `SocialProtocol::moodTally()`; one line per Awake tick in `main.cpp`. No new
  radio field; forged frames capped at one mood change per minute (ADR-0012).
- review-local: Must 0 · Should 9 (fixed) · Nice 7 (4 fixed). Codex P2 (a touch-down did not
  break the calm before contagion) fixed in the PR.
- Gate: 238 native tests, both board builds, benches PASS, gitleaks clean, CI green, new lib
  code 100 % lines. SonarQube red on main outside the diff (S3776 in `cubbies_case.py` from #46,
  no Python coverage.xml): owner waiver, tracked in #53.
- Tooling: PlatformIO needs `REQUESTS_CA_BUNDLE=/etc/ssl/certs/ca-certificates.crt` behind the
  TLS-inspecting endpoint agent.

## 2026-10-19

### Print pack for the Grasse fablab (issue #45) — **PR #46 merged** (`e7effe1`)

- `cubbies_case.py` cuts a tolerance coupon from the real shells (left hook and its pocket, the
  back-wall frame around the cover rebate, printed with a real cover) and checks it (check 18:
  whole hook, whole pocket, full rebate). It also writes `hardware/case/export/print/`: parts
  already turned and resting on the bed, plus `coupon-plate.3mf` and `cubbies-plate.3mf`.
- `hardware/case/PRINT.md`: one-page fablab sheet (files, PLA / 0.2 mm / 4 perimeters / no
  supports, coupon first, what to check, results to `docs/hardware/assembly.md`).
- Owner: fablab printer and slicer unknown, so the 3MF plates are geometry only and open in any
  slicer; a slicer project is saved once the slicer is known. Front shell prints front face down
  (mechanical spec), not up as the brief said.
- Codex raised 1 valid point (the coupon check could pass without the pocket), fixed in the PR.
- Gate: 220 native tests, both board builds, electronics benches (`hardware/electronics/sim/run.sh`,
  all PASS), ruff and gitleaks clean on the diff, CI green. Not run: SonarQube.
- Open: print-and-fit at the fablab; pre-existing ruff findings unchanged.

### FreeCAD enclosure script with the module bay (issue #42) — **PR #43 merged** (`d94528e`)

- `hardware/case/cubbies_case.py` (ADR-0010, CC BY-SA 4.0) generates the front shell, the rear
  shell and the ADR-0016 bay cover headless (`freecadcmd`), then STL/STEP/FCStd under
  `hardware/case/export/`. It runs 17 dimension checks first and exports nothing if one fails
  (envelope, walls, openings, bay, J1 parameters, hook clearance, barb direction, engagement
  and release, hook strain against PLA, cover push-in stop, part collisions); mutation-tested.
- Owner MCDA: 40 mm cube with the bay above the XIAO (460/500, 46 mm shell 340); FreeCAD 1.1.1
  AppImage behind a `~/.local/bin/freecadcmd` wrapper (440/500, snap 275): no sudo, pinned
  version, headless for agents.
- review-local: Must 4 (shell barbs reversed, cover hooks never engaged and no push-in stop, a
  vent slot through the corner, cover hook strain ~18 %) · Should 9 · Nice 4, all fixed. Codex
  (enabled on the repository) then raised 3 valid points, fixed in the PR: 45° releasable barb
  back faces (UC12 cover removal), front shell printed face down, DS1 held by 3M foam tape.
- Gate: 220 native tests, both board builds, benches, ERC 0, gitleaks clean, SonarQube PASSED
  (new coverage 93.9 %, `cubbies_case.py` 92 % under FreeCAD's Python), docstrings 91 %, CI green.
- Open: print-and-fit at the mechanical CDR (OLED module and XIAO sizes are estimates); print
  pack for the Grasse fablab proposed as a follow-up; pre-existing ruff findings in
  `firmware/tools/golden_sheet.py` and `hardware/electronics/sim/calc.py`.

## 2026-10-16

### CDR paper items (issues #30, #31, #32) — C-0013, C-0014, C-0015 — **PR #38 merged** (`1580cd5`)

- Source reading: the XIAO ESP32-C3 LDO is a **Torex XC6210B332MR** behind a 500 mA PTC and a
  Schottky (Seeed schematic), not a TLV75733. C-0013 supersedes C-0002: θJA derived 132–400 °C/W
  (167 nominal); rail window 3.234–3.366 V carried to every bench (buzzer peak 37.4 mA).
- Owner MCDA: J1 budget 50/75 mA kept provisional, bench LDO temperature at 50 mA on J1 is a CDR
  exit criterion (415/500); 10 kΩ pull-up R6 on GPIO8 (no pull-up on the XIAO, 435/500);
  closed-form second method `crosscheck.py` instead of a second SPICE engine (410/500).
- review-local: Must 5 · Should 9 · Nice 4, all Must/Should fixed; SonarQube PASSED after 1 issue
  and 1 regex hotspot fixed; Python coverage 96 %; gitleaks clean; ERC 0; benches PASS; CI green.
- Still open for the bench (#33): LDO temperature, Schottky Vf from its datasheet.
- Follow-up **PR #40 merged** (`0e68452`): root README (status, XC6210, J1, layout) and
  architecture risks (R6 on GPIO8, provisional J1 budget). Its full local gate ran after the
  merge (all green); owner rule since then: the full local suite runs before every push, docs
  included.

### Expansion port design (issue #18) — ADR-0016, C-0012 — **PR #36 merged** (`fc3b183`)

- REQ-F-20, REQ-NF-12, UC12 "Add a capability by plugging a module", views under
  `diagrams/expansion-port/` (boot probe sequence, component), traceability and verification
  rows.
- C-0012: a J1 module may draw ≤ 50 mA continuous, ≤ 75 mA peak (owner validated 50/80, confirmed 75 before the PR; the
  calculation trims the peak because C-0001's peak is 420.3 mA). `calc.py` asserts both.
- Owner MCDA: internal module bay behind a clipped rear cover (415/500 vs outside slot 365,
  fixed internal 335); bay 22 × 22 × 6 mm in the mechanical spec (FreeCAD script not written yet).
- Plug-and-play principle (ADR-0016 D3): allowlisted I2C probe at boot with identity check,
  timeout, reserved sensor addresses, one firmware; code at the first module's PDR.
- review-local: Must 2 · Should 6 · Nice 4, all fixed; SonarQube PASSED (coverage 94 %), gitleaks
  clean, 220/220 native, benches PASS.
- Owner PDR validation recorded in the PR. No Copilot/Codex review (owner: local gates only for now); CI green.

### KiCad schematic `cubbies-v1.kicad_sch` — benches fed from the schematic — **PR #34 merged** (`afb4ede`)

- Native KiCad 9 schematic + PDF from the GPIO contract (ADR-0015), BOM and assembly guide:
  XIAO (U1, 2×7), SSD1331, INMP441, TTP223, GY-521, GY-302, buzzer stage, RES# RC, 47 kΩ SDA
  pull-up. Every symbol has a Justification field citing C-NNNN / ADR. ERC: 0 violations.
- I2C expansion port J1 (issue #18): JST-SH 4-pin Qwiic/STEMMA QT, owner MCDA 450/500 (2.54 mm
  header 410, 5-pin with interrupt 310).
- `sim/schematic_values.py` exports the SPICE netlist with kicad-cli and writes `schematic.lib`
  (`.param` + `.csparam` per R/C); the four benches read R1–R5 and C1 from it, `run.sh` refreshes
  it (committed copy used, with a message, when kicad-cli is absent). Tolerances, corners and
  module pull-ups stay in the benches; `i2c-bus.txt` changed only because the networks are now
  computed exactly. Calculation log inputs unchanged. Sensitivity checked: R1 set to 68 Ω on the
  sheet makes `run.sh` fail on C-0003.
- review-local: Must 1 · Should 9 · Nice 7, all Must/Should fixed; SonarQube: 1 issue fixed, new coverage 93.4 %, regex hotspot reviewed Safe, quality gate PASSED.
- No external review: Codex hit its usage limit. CI green (native tests, both board builds,
  CodeQL, secret scan, dependency review).

### Hardware validation — calculation log and ngspice benches — **PR #28 merged** (`4b72e59`, ADR-0015)

- V-SEA method applied: append-only `docs/hardware/calculations/log.md` (C-0001..C-0011, tiered),
  ngspice 42 benches with worst-case corners under `hardware/electronics/sim/` (`sh run.sh`),
  tier-3 lines in `calc.py`.
- Three drafted choices failed and were fixed (owner, scored options, ADR-0015): buzzer and SDA
  swapped so the strapping pin GPIO2 reads 1 at reset (430/500); display RES# RC 10 kΩ / 1 µF +
  1N4148 (470/500); buzzer series resistor 82 Ω (440/500); after the pre-push review, a 47 kΩ
  board pull-up so GPIO2 boots high with no I2C module fitted (485/500).
- Benches are self-validating (`sh run.sh` fails on any `FAIL C-NNNN`, negative controls print
  `EXPECTED-FAIL`); review-local: Must 3 · Should 8 · Nice 4, all Must/Should fixed.
- No external review: Codex hit its usage limit, Copilot cannot be requested (not a collaborator).
  CI green (native tests, both board builds, CodeQL, secret scan, dependency review).
- Open before the CDR: LTspice second engine on Tier 1 entries, LDO θJA/dropout from the
  datasheet, bench boot/download check, I2C rise-time measurement.

## 2026-10-15

### Brick F5 — adapters and `main.cpp` — **PR #26 merged** (`ff7b509`, ADR-0014)

- Seven thin adapters in `firmware/src/`: `MillisClock`, `Ttp223Touch`, `NvsStorage`
  (Preferences, typed), `BuzzerAudio` (LEDC, duty table 2/8/20/50 %), `I2sMic` (rms + peak,
  samples never leave), `Ssd1331Display` (LovyanGFX 1.2.33 pinned), `EspNowRadio` (channel 1,
  8-slot queue, length drop in the callback). `main.cpp` wires the boot (Wi-Fi, seeded Prngs,
  identity, invitation window, ritual) and the 40 ms tick in the 03-component order.
- Owner decisions (scored options): note stepping by `esp_timer` (470/500), FreeRTOS queue for
  RX (480/500), explicit channel constant 1 (380/500, after a deeper analysis). The volume table
  came from calculations.md (no new decision). Decisions recorded in 03-component.
- Local review: Must 3 · Should 4 applied (I2S partial reads, init-failure guards, STA power
  save off, stale boot frames purged); Nice grouped in issue #25.
- Codex review (3 rounds), every thread answered inline: 4 P2 fixed in `main.cpp` (gate ticked
  before any sound-producing output, wake-up melody at normal start per 02a, played after the
  adoption sound ends, MAC zeroed on a read failure). Third round clean.
- Both board envs build with no warning, 220 native tests green; bench checklist in
  `docs/hardware/bench-f5.md` (issue #16 checks included).

### Brick F4 — social presence — **PR #22 merged** (`63b0103`, ADR-0014)

- PDR status: REQ-F-10 was already covered by the cube-core PDR (ADR-0013); the `social-group`
  PDR (G2/G3) stays deferred. New state diagram social-presence/05a (neighbour entry and
  greeting) with its transition table; 03-component note and traceability matrix amended.
- Owner decisions (scored options): `IRadio` pulled by the lib, which drains 4 frames per tick
  (475/500); greeting budget as a sliding window over the last 6 greetings (470/500); the cube's
  own state passed per tick as `SelfState`, mood byte computed by the codec (445/500); F4
  review-local report overwrites F3's (475/500).
- Design gap found while writing the tests: a newcomer that leaves before its greeting is still
  owed one (`greeted` bit kept while Absent, 05a amended).
- TDD: `PresenceCodec` (allowlist, drop reasons, 05b mood byte, 200 000-input fuzz) and
  `SocialProtocol` (16-slot table, absent eviction, cooldown, re-greet hysteresis, strict sliding
  budget, jittered broadcast, wrap), `LoopbackRadio` fake, two cubes greeting each other once.
- Local review: Must 1 · Should 11 applied (Waiting refresh row, exact boundaries, flood
  assertions, `ports/Mac.h` so the port no longer includes core, `findSlot()`, 2^32 aliasing of
  absent entries and of the greeting ring); Nice 6 grouped in issue #23.
- Codex review (2 rounds, no Copilot), every thread answered inline: one P2 fixed in TDD, an
  Absent entry older than 2^32 ms could alias as recent and mislead the eviction order, so the
  tick now frees Absent entries past T_regreet (05a row added). Second round clean.
- 220 native tests green, both board envs build, CI green. `EspNowRadio` and the `main.cpp`
  wiring are F5.

### Brick F3 — identity and boot — **PR #20 merged** (`93c9019`, ADR-0014)

- Design first: new state diagrams identity/05a (invitation window) and 05b (adoption ritual),
  amendments to 02a, 02b, 03, 05c (`holdMs()`, `consumeCurrentPress()`, `Consumed` state) and
  05e (ritual sounds). PDR validated by the owner.
- Owner decisions (scored options): 8-colour palette, forward only (445/500); one fixed ritual
  tick, pitch per index deferred to the sound brick (425/500); `InvitationWindow` as its own lib
  class (435/500); double tap = +2 (470/500); a press already down at the end of the settle is
  consumed (470/500); window and ritual return an `IdentityOutput` that `main.cpp` applies
  (445/500); any gesture restarts the 60 s timeout (470/500). Adoption sound rank 0.
- Five TDD steps, each red then green: `resolveIdentity` (FNV-1a MAC hash mod 8, typed
  `IStorage` port, `FakeStorage`); Gesture classifier hold/consume; ritual sounds in the Sound
  gate; `InvitationWindow`; `AdoptionRitual` (single NVS write, fail closed, timeout).
- Local review: Must 4 · Should 6 applied (02b aligned, window press read before expiry +
  gauge clamp, edge tests); Nice grouped in #19.
- Codex review (2 rounds, no Copilot): two P2 threads, both verified and fixed in TDD — a Tap
  pending at the window close leaked to the normal loop, and a press whose edge was the
  settle-end tick was not consumed. `consumeCurrentPress()` now drops a pending Tap and returns
  to Idle at once when the pad is released; the window consumes at the settle end and on
  Declined (owner choice 465/500). Second round clean.
- 189 native tests green, both board envs build. NVS adapter and `main.cpp` wiring are F5.

### Brick F2 — behaviours — **PR #12 merged** (`ef10f61`, ADR-0014)

- Seven TDD steps, each a red then a green commit: Surprise/Joy blend from a held TouchDown;
  `GestureClassifier` ← `ITouchSource` (new 05c); `SoundClassifier` ← `IMic` rms + peak over an
  adaptive baseline (new 05d); `MoodEngine` (05a); `SleepCycle` (05b); `SoundGate` → `IAudio`
  (new 05e); `StimulusRouter` as pure functions (03 routing rule, S3 reactions, effect mappings).
- Owner decisions (scored options): stroke at 1.5 s, tap max 400 ms; sound thresholds as ratios
  over a baseline frozen during a sound; any TouchDown wakes; Waking covers its wake animation,
  never under 1 s (1 s from Dozing, 1.2 s from Asleep, PR #12 review);
  sounds are note tables in `lib/`, volume level 0..3 (V1 constant 1), gate muted while Dozing
  or Asleep via `setSleepState()`, overlap by rank (strictly higher replaces, no queue);
  `Released` is a mood stimulus so a medium press wakes a Bored or Tired mood (note in 05a).
- Codex review (5 rounds, no Copilot: out of credits), every thread answered inline. Fixed in
  TDD: Loud started a tick late; a clap leaked its loud run; an expired burst whose peak fell was
  dropped; Voice was timed from a low-rms bang (voice and loud now use their own runs of
  at-level ticks); the Asleep wake Yawn (1.2 s) outlived Waking (now 1 s from Dozing, 1.2 s from
  Asleep). Doc fix: the 03 sound-class table in ratio form (`e0df866`). Kept by owner decision:
  the 40 ms tick resolution of the double-tap window (05c note).
- 155 native tests green, both board envs build. `main.cpp` wiring and adapters are F5.
- Backlog: #13 (lib refactor), #15 (test nits), #16 (F5 wiring checks); #14 fixed in the PR.

### Brick F1b — reactions overlay and identity frames (branch `feat/f1b-expressions`, ADR-0014)

- TDD in two commits (red, then green) on the extraction trigger recorded in the F1 review:
  `Timeline` (start + duration + phase, wrap-safe, 64-bit phase) now drives blinks, lid moves,
  reactions and identity animations. `Reaction` enum (TouchDown, Surprise, Joy, Purr, LookUp,
  Yawn, Wake, Greet) drawn as an overlay on the mood frame; identity frames (invitation with
  gauge, ritual with pulsing border, adoption wink + arcs, error flashes) replace the face.
  Three layers: identity > reaction > mood. Blinks are deferred, never dropped.
- Pre-push `review-local` gate (design, docs, tests): Must Haves applied — identity frames now
  drift like the mood frame (REQ-NF-08), Purr has its own ramp/hold/release on the reaction
  timeline instead of borrowing the sleep lid move and never opens eyes the sleep cycle closed,
  the identity sequence diagrams 02a/02b now use the code names (`playAdoption`, `showError`,
  `clearIdentityFrame`, `showRitualFrame(palette[i])`), the no-blink-during-reaction test was
  vacuous (now seeded from the observed blink deadline, 8 seeds), the smile carve on a closing
  eye was non-monotonic at 18 px (edge depth now follows the centre depth). `Lids` flags
  became an `Arc` enum, tuning numbers named, static reactions keep one golden each.
- 73 native tests green, 28 golden states on the contact sheet (owner validated the first
  draft of the full face vocabulary on 2026-10-15), both board envs build (xiao_c3 273 KB,
  c3_supermini 298 KB flash).
- Open for F1c: TouchDown widening vs the double-tap window (owner decision), generalized
  12-parameter lids, `eyes_lab` native tool, emotion catalogue.

## 2026-10-14

### Brick F1 — firmware skeleton and eyes — **PR #9 merged** (`211137e`, ADR-0014)

- **Decisions** (ADR-0014, scored options): `display adapter: LovyanGFX 1.2.33` — SSD1331 and
  ST7735 in one package, DMA keeps the 40 ms tick; Adafruit rejected (no DMA on ESP32), raw
  SPI rejected (driver to maintain). `tests: TDD on lib/, golden images for the eyes, bench
  for adapters` — the conception is tabular, each row is a test; test-after rejected (tests
  would describe the code, not the table).
- First code of the project, TDD in two commits (red tests, then green): ports `IDisplay` and
  `IClock`, `Prng` (PCG32, reference value checked), `Framebuffer` 96×64 RGB565 with clipped
  primitives, `EyesRenderer` (two rounded eyes in the identity colour, five mood shapes,
  blink every 2–6 s aligned on the 40 ms tick, idle glances, one-pixel drift per minute in every
  state, closed eyes for sleep). 34 native tests green, both board envs build.
- Golden images (10 states) generated and reviewed on the contact sheet. References are raw
  RGB565 dumps; the PNGs come from a minimal encoder of our own (stored deflate, CRC-32,
  Adler-32, known-answer tests). The vendored stb headers were dropped the next day: 9 700
  third-party lines and 13 high CodeQL alerts for two functions used (owner decision after
  scored options; the CodeQL exclusion alternative rejected).
- Pre-push `review-local` gate (design, docs, tests, correctness): 5 Must Have and 22 Should
  Have applied before push, notably the blink-gap test that only passed thanks to its seed
  (FS1 reworded: 2–6 s of open eyes measured from the reopening), the golden update mode that
  passed silently, `openEyes()` rescheduling the blink, framebuffer primitives bounded against
  extreme inputs, the 12 KB-on-the-stack hazard documented for `main.cpp`.
- Owner validated the five mood frames and the closed eyes as golden references (2026-10-15)
  and chose to complete the face vocabulary in a dedicated brick **F1b** before F2 (reactions
  and identity frames with a shared `Timeline`; ADR-0014 amended), after scored options.

### cube-core PDR passed (branch `docs/pdr-cube-core`, ADR-0013)

- Four-pass review of the eight diagrams against the requirements: five blocking
  contradictions (use-case numbering, ritual entry, touch latency vs double-tap window, sleep
  timings vs FS5, three tier-A requirements neither modelled nor deferred) and 14 Should Haves.
- **Decisions** (ADR-0013, scored options and two deeper analyses):
  - `randomness: lib-owned PCG32` — seeded from `esp_random()` after Wi-Fi init; the `IRng`
    port was a single-implementation port whose fake re-implemented a PRNG.
  - `ritual entry: post-boot invitation window` — the TTP223 calibrates during its first 0.5 s,
    so "hold while plugging in" may never be detected; rejected as unreliable.
  - `volume: second step of the adoption ritual (V1.x)` — discoverable, no collision with the
    awake gestures; triple tap rejected (lengthens tap classification), mother cube rejected
    (takes the setting away from the colleague).
  - `sleep timings: doze 10 min, sleep 30 min` — matches FS5 and distinguishes a coffee break
    from a meeting; any stimulus leaves Tired.
  - `REQ-F-11/12/13: deferred` — their own `social-group` PDR so cube-core firmware can start.
- Diagrams 01, 02a, 02b, 03, 05a, 05b, presence and data-flow amended (MAC by value, mood byte in
  the codec, tick-driven ritual, entry press consumed, touch-down stimulus, sound classes, tick
  budget, mic privacy note, greeting policy owned by the presence sequence); specs UC1/UC3/UC4/UC6
  rewritten, UC2 retired, matrix corrected, CLAUDE.md rules aligned. Pre-push gate: design and
  docs reviews, 6 Must Haves (ADR totals, entry press, codec edge, stale wording) applied.
  Next: firmware T1/T2/T8 can start.

### Architecture README restructured as arc42-lite — **PR #7 merged** (`83a4ae2`)

- Post-merge pass after PRs #1–#6: every 2026-10-14 entry now carries its PR number and merge
  SHA; stale "next" sentences in merged entries updated in place.
- Dependency bumps are not logged individually (PR #2, `0e2d7c1`, Dependabot `actions/cache`
  5.1.0 → 6.1.0, is the first).
- `docs/architecture/README.md` is now the arc42-lite map decided in ADR-0011 (goals,
  constraints, C4 context, strategy, building blocks and ports, crosscutting concepts, quality,
  risks, glossary) with the UML index kept at the end. Relative links checked, Mermaid rendered.

### Design dossier scaffolded — **PR #4 merged** (`8b86ae8`)

- Owner decisions after scored options (ADR-0011): dossier = arc42-lite overview + functional
  requirements (NF X50-151 style) + Cockburn textual use cases + UML + traceability matrix +
  hardware specs with a signed GPIO contract + OSHWA assembly guide + PDR/CDR gates;
  verification = calculations and targeted ngspice simulations committed with plots, native
  tests, golden-image tests of the eyes through a native display adapter, bench measurements;
  Wokwi for exploration only (no SSD1331, no I2S mic in its catalogue).
- Enclosure tooling (ADR-0010): FreeCAD 1.1 driven by a versioned Python script, generated
  `.FCStd`/STEP/STL as artefacts, `freecad-mcp` for inspection; `.FCStd` is a binary zip, so the
  script is the reviewable source. KiCad follows the V-SEA method (KiUtils + `kicad-cli` ERC,
  no MCP; provisional, no ADR yet).
- Written: `specs/requirements.md` (9 service functions, 10 constraints, 15 functional and 11
  non-functional requirements), `specs/use-cases.md` (11 UCs + 3 traced system behaviours), `verification-plan.md`,
  `gates.md`, `traceability-matrix.md`, `docs/hardware/{electronics-spec, calculations,
  mechanical-spec, assembly}.md`, `docs/research/state-of-the-art.md`; roadmap gains S12 (rare
  gag, owner request, cartoon level, rate-limited) and T8–T10; CLAUDE.md non-negotiables updated.
- The first UML study (eight diagrams, separate session, branch `docs/uml-study`) is kept as a
  first draft and re-validated against the requirements at the `cube-core` PDR. The arc42
  restructure of `docs/architecture/README.md` followed in its own PR (entry above).

### First UML study drafted — **PR #5 merged** (`a027977`)

- Eight Mermaid diagrams under `docs/architecture/diagrams/`: `cube-core` (use case by domain,
  component lib-vs-adapters with eight ports, mood engine state, sleep/wake state), `identity`
  (boot resolves identity, adoption ritual entered by the held-at-boot gesture),
  `social-presence` (presence sequence with greeting policy, frame data-flow with the 8-byte v1
  PRESENCE layout).
- Every block rendered with `mmdc` without a parse error. Three critical review passes
  (architecture guardian) before the `review-local` gate. First pass: ten Must items (MAC in the
  payload in one diagram and not the other, quiet hours with no time source, audio policy and
  gesture timers in adapters against the lib-purity rule, ports not matching the sequence calls,
  a system event modelled as a use case, shake needing the tier-B IMU). Second pass: four Must
  (wake-up melody owned by three diagrams, a Sleep/Mood circular dependency, a Router → Identity
  edge the ritual never uses, a storage edge with nothing stored) and a greeting policy that
  could skip a newcomer. All fixed. Third pass: no Must left, two stale use-case numbers from the renumbering and
  the "greet while awake" wording fixed. `review-local` gate (design, docs, security,
  correctness): four Must (receive-path rate budget and length check in the callback, spoofing
  risk stated honestly, one stale reference), all applied; report in
  `docs/architecture/review-local.md`.
- Design choices submitted as scored options (Q&A, two rounds with deeper analysis) and
  **validated by the owner**: quiet hours out of V1 (no time source; silence comes from sleep,
  then from the light sensor in S8), discrete moods, wake restarts in Curious, greeting as a
  local rate-limited stimulus (GREET frame re-evaluated with G3), palette index on the air with
  a version bump on palette change (RGB565 revisited in V1.5), ritual entered only by the
  held-at-boot gesture, derived MAC colour not persisted, constant default volume until a UC6
  gesture is chosen, unauthenticated ESP-NOW broadcast accepted as residual risk. Consequences
  applied: `CLAUDE.md` "never loud" rule reworded, roadmap S4/S5/S8 reworded.
- The accepted ESP-NOW residual risk and the V2 fleet-key hook are recorded in ADR-0012 (amends
  ADR-0005, PR #3). Double tap cycling backwards in the ritual stays open until the palette size.
- Next: backlog items S1–S7 and G1 become issues with these diagrams as
  their contract.

### Repository public, private-repository guards removed — **PR #6 merged** (`96d781f`)

- The repository went public after PR #1 (security CI baseline) merged.
- Removed the `if: ${{ !github.event.repository.private }}` guards from `codeql.yml`,
  `dependency-review.yml` and `scorecard.yml`; the three workflows now run for real (CodeQL on
  `actions` and `c-cpp`, dependency review on PRs, Scorecard on `main` after merge).

### ADR-0012: unauthenticated ESP-NOW broadcast recorded as an accepted residual risk (amends ADR-0005) — **PR #3 merged** (`c8649ae`)

- The social-presence UML study (branch `docs/uml-study`, data-flow and sequence diagrams) found
  that ESP-NOW broadcast cannot be encrypted, that the source MAC is forgeable, and that V1 has
  no path to provision a key. An attacker in radio range can flood the 16-slot neighbour table,
  impersonate a cube's presence and mood byte, or trigger one greeting per cooldown.
- Four options scored (accept bounded risk / fleet key in NVS at adoption / per-peer unicast
  keys / BLE instead). Decision: accept in V1, bounded by eviction of absent entries only,
  greeting cooldown plus a global budget, allowlist and rate-bounded receive path, RAM-only and
  eyes-and-beep-only effects. ADR-0005's transport choice stands; its status line now reads
  "Amended by ADR-0012".
- V2 hook recorded: fleet key in NVS, never in source. V1.5 relayed OTA must ship a signed image,
  not a hash alone.

### Security CI baseline — **PR #1 merged** (`9b54ecf`)

- Owner decision: the repository goes public (free Copilot review and analysis tools) only
  after the public release checklist passes; the missing item was the CI secret-detection job.
- Added the `security-ci-baseline` set, SHA-pinned, same set as the owner's other repositories:
  Gitleaks (full history, weekly), CodeQL (`actions` + `c-cpp` traced on the native host
  build), dependency review, OSSF Scorecard, Dependabot for GitHub Actions; plus the CI workflow
  (native tests, both board builds) and `.gitleaks.toml`.
- CodeQL, dependency review and Scorecard are guarded by `if: !repository.private` (code
  scanning and dependency review need a public repository or Advanced Security, and Scorecard's
  official template has no `contents: read` for a private checkout); the guards go away in the
  public-release PR. Until then only CI and Gitleaks are meaningful checks.
- Local gitleaks over history and working tree: no leaks. Pre-push `review-local` gate run:
  no Must Have; the Should Haves (private-repo guards, `cancel-in-progress` limited to pull
  requests, comment accuracy, CLAUDE.md mention of CI) applied before push.

### Project kick-off: scoped Q&A session, decisions recorded, repository scaffolded

- Owner's intent: a fleet of small cube desk companions (OLED eyes, mic, buzzer) that interact
  with each other, offered to office colleagues on an "adoption day", one colour per cube,
  3D-printed enclosures. Prototypes first (2–3 cubes), then more than 10.
- Desk research on the existing landscape (Dasai Mochi clones on ESP32-C3, RoboEyes / OliEyes
  eye libraries, ESP-NOW vs BLE for peer discovery, PlatformIO vs pioarduino core status).
  Finding: solo desk companions are well covered; the multi-cube social layer is the
  differentiator.
- Nine structuring decisions taken through scored Q&A and recorded as ADR-0001..0009:
  concept (solo companion + proximity social layer), power roadmap (USB-C → LiPo → Qi), board
  (XIAO ESP32-C3), stack (PlatformIO + pioarduino, Arduino core 3.3.x), radio (ESP-NOW
  broadcast), display (SSD1331 OLED, ST7735 LCD compared on prototypes), sensor tiers under an
  11-GPIO budget, identity (MAC default + adoption ritual in NVS), licensing (MIT code,
  CC BY-SA 4.0 enclosure).
- Repository scaffolded: README, BOM, roadmap with prioritised backlog, ADRs, architecture
  conventions, PlatformIO skeleton with two envs (XIAO C3, C3 Super Mini) and a native test.
  Private GitHub repository `benoit-bremaud/cubbies` created and `main` pushed.
- Next: UML study (use cases, mood state machine, ESP-NOW presence sequence, component view)
  by PR, before any firmware; order prototype parts (BOM).
