benoit-bremaud/cubbies/hardware/electronics/cubbies-v1.pdf

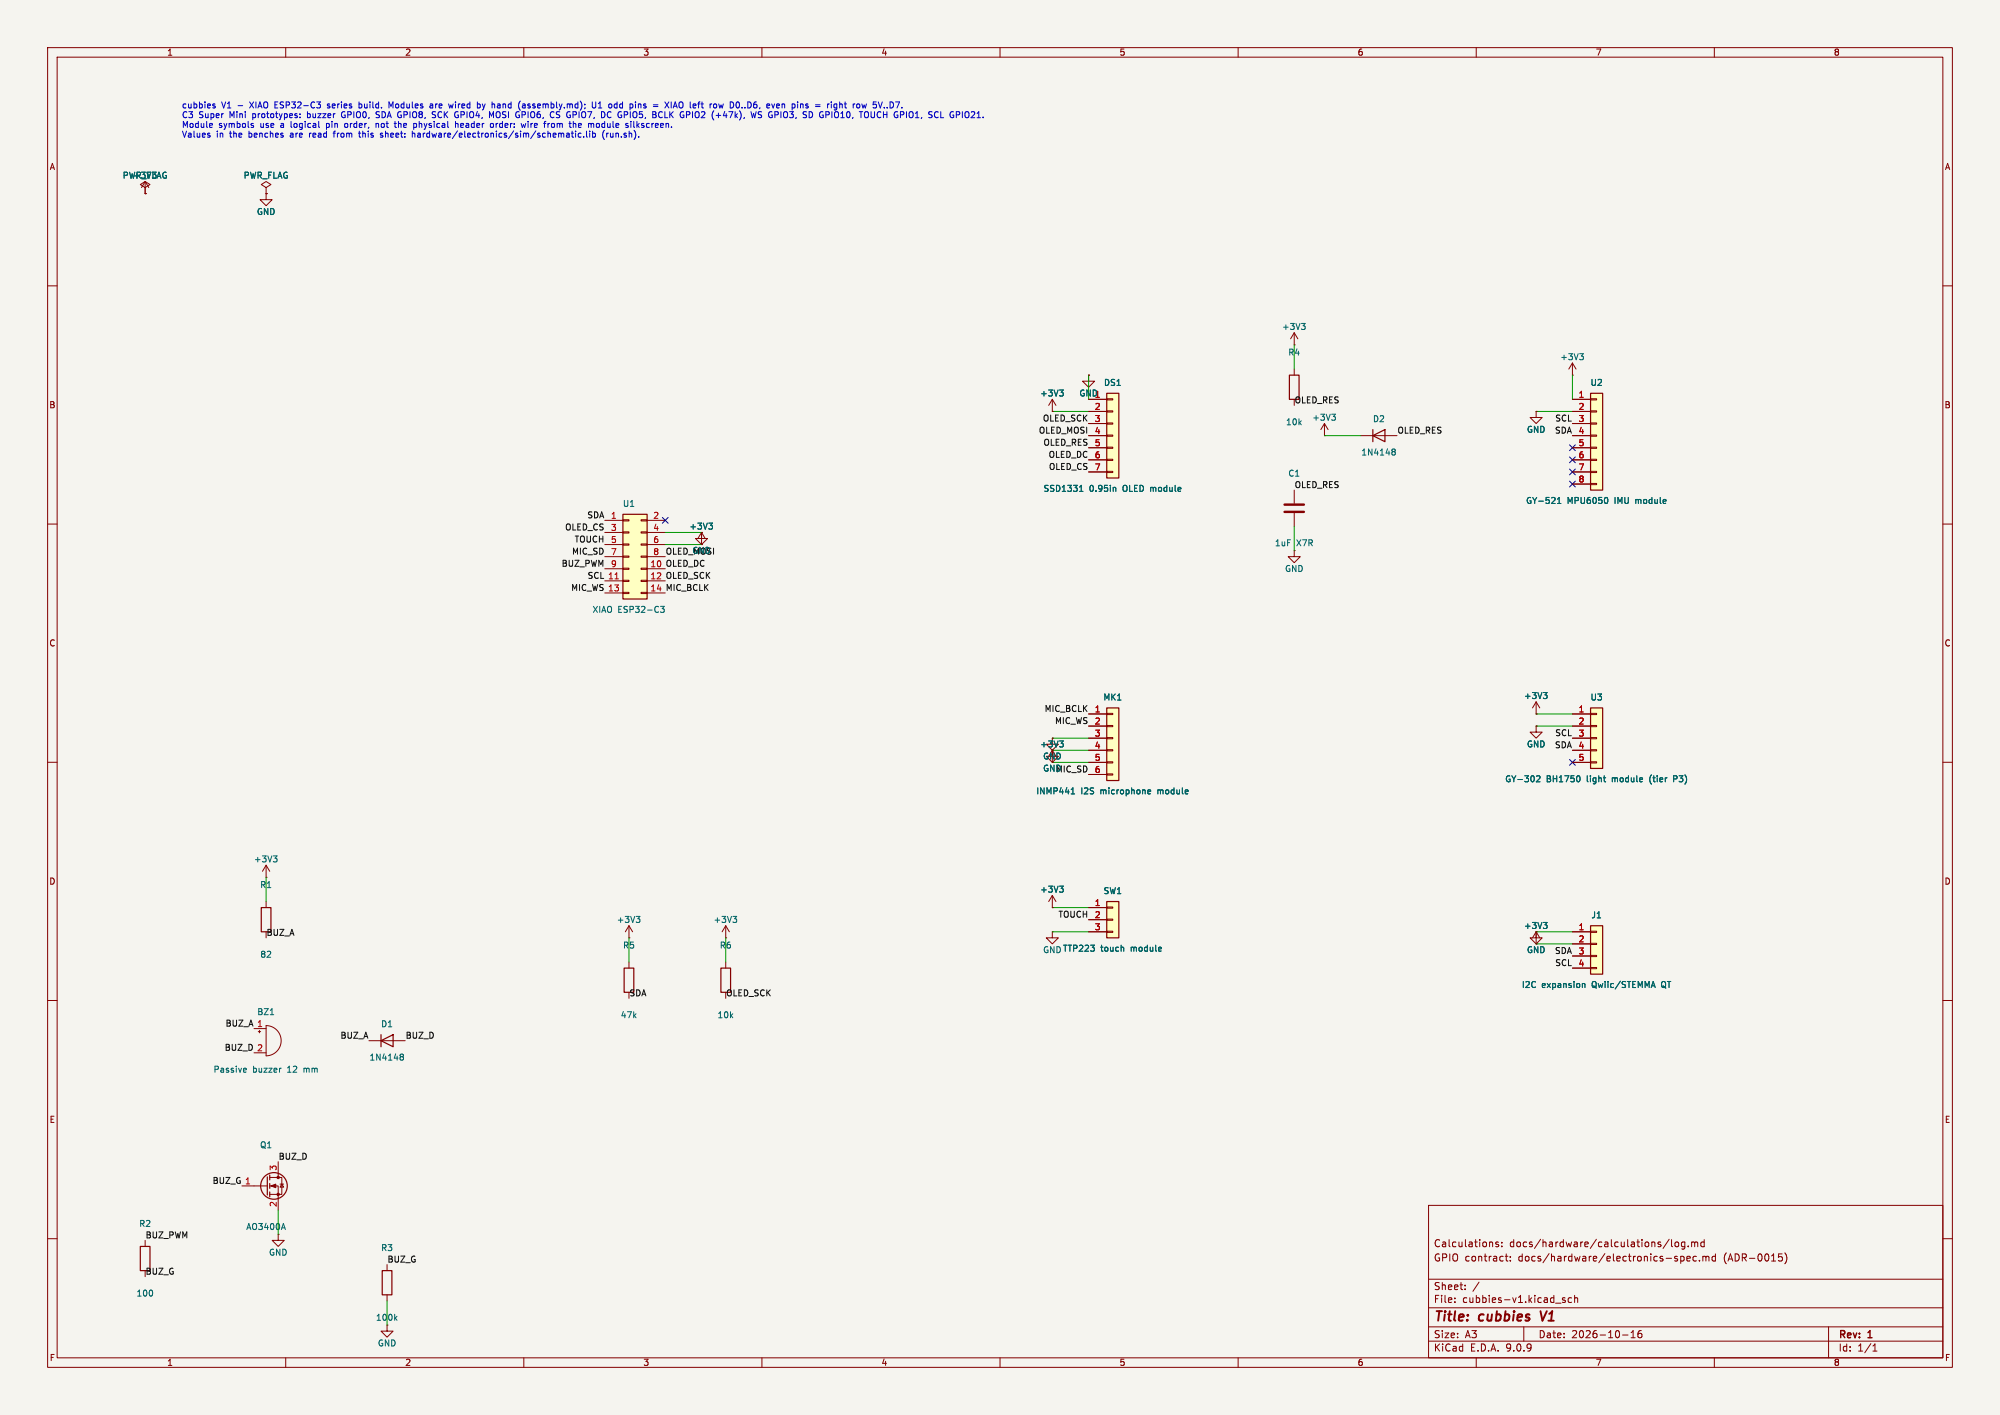
[picture p10: page 1]
