benoit-bremaud/cubbies/hardware/electronics/cubbies-v1.kicad_sch

## KiCad design hardware/electronics/cubbies-v1.kicad_sch (2026-10-16)

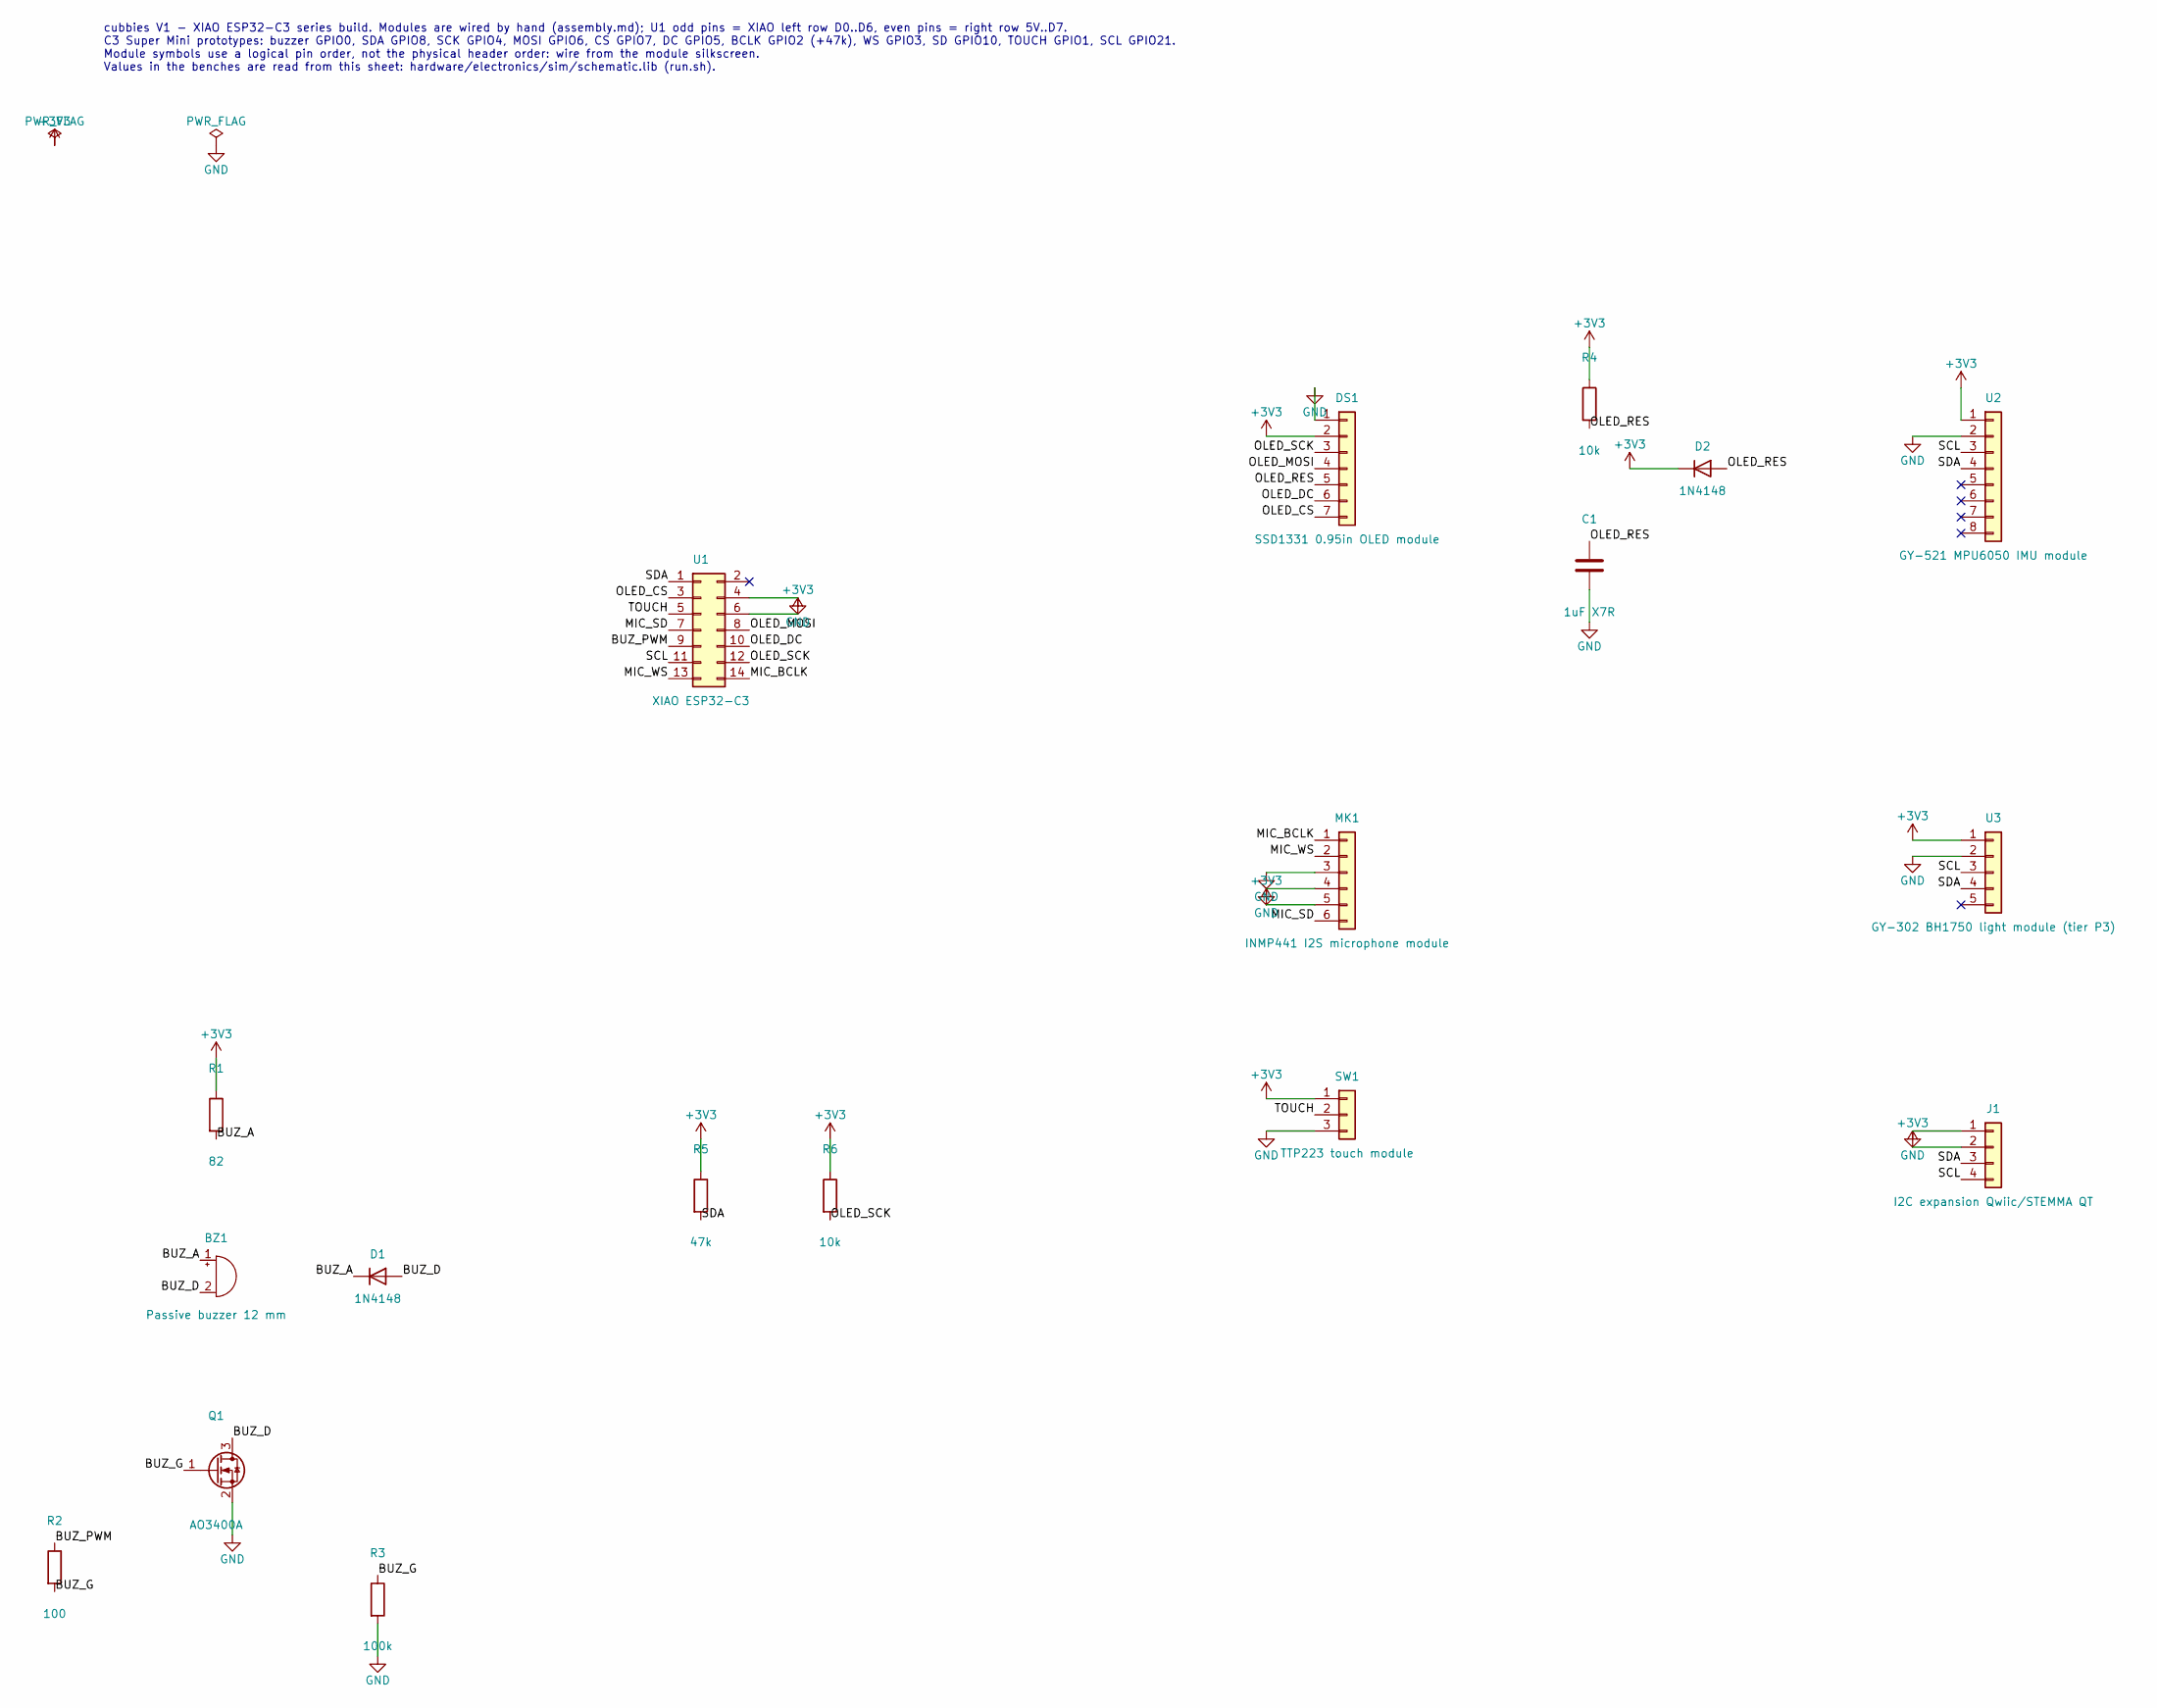
[picture p11: schematic cubbies-v1.kicad_sch]

Parts:
BZ1: Passive buzzer 12 mm
C1: 1uF X7R; C_Disc_D5.0mm_W2.5mm_P5.00mm
D1, D2: 1N4148; D_DO-35_SOD27_P7.62mm_Horizontal
DS1: SSD1331 0.95in OLED module
J1: I2C expansion Qwiic/STEMMA QT; JST_SH_SM04B-SRSS-TB_1x04-1MP_P1.00mm_Horizontal
MK1: INMP441 I2S microphone module
Q1: AO3400A; SOT-23
R1: 82; R_Axial_DIN0207_L6.3mm_D2.5mm_P7.62mm_Horizontal
R2: 100; R_Axial_DIN0207_L6.3mm_D2.5mm_P7.62mm_Horizontal
R3: 100k; R_Axial_DIN0207_L6.3mm_D2.5mm_P7.62mm_Horizontal
R4, R6: 10k; R_Axial_DIN0207_L6.3mm_D2.5mm_P7.62mm_Horizontal
R5: 47k; R_Axial_DIN0207_L6.3mm_D2.5mm_P7.62mm_Horizontal
SW1: TTP223 touch module
U1: XIAO ESP32-C3
U2: GY-521 MPU6050 IMU module
U3: GY-302 BH1750 light module (tier P3)

Connections:
+3V3: D2.1 (K), DS1.2, J1.2, MK1.5, R1.1, R4.1, R5.1, R6.1, SW1.1, U1.6, U2.1, U3.1
BUZ_A: BZ1.1 (+), D1.1 (K), R1.2
BUZ_D: BZ1.2 (-), D1.2 (A), Q1.3 (D)
BUZ_G: Q1.1 (G), R2.2, R3.1
BUZ_PWM: R2.1, U1.9
GND: C1.2, DS1.1, J1.1, MK1.3, MK1.4, Q1.2 (S), R3.2, SW1.3, U1.4, U2.2, U3.2
MIC_BCLK: MK1.1, U1.14
MIC_SD: MK1.6, U1.7
MIC_WS: MK1.2, U1.13
OLED_CS: DS1.7, U1.3
OLED_DC: DS1.6, U1.10
OLED_MOSI: DS1.4, U1.8
OLED_RES: C1.1, D2.2 (A), DS1.5, R4.2
OLED_SCK: DS1.3, R6.2, U1.12
SCL: J1.4, U1.11, U2.3, U3.3
SDA: J1.3, R5.2, U1.1, U2.4, U3.4
TOUCH: SW1.2, U1.5

Notes on the sheet:
cubbies V1 - XIAO ESP32-C3 series build. Modules are wired by hand (assembly.md); U1 odd pins = XIAO left row D0..D6, even pins = right row 5V..D7. C3 Super Mini prototypes: buzzer GPIO0, SDA GPIO8, SCK GPIO4, MOSI GPIO6, CS GPIO7, DC GPIO5, BCLK GPIO2 (+47k), WS GPIO3, SD GPIO10, TOUCH GPIO1, SCL 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
