benoit-bremaud/cubbies/(commit log)

2026-10-14 chore: scaffold the cubbies repository
    Conception kick-off of cubbies, a fleet of ESP32-C3 cube desk companions
    (colour OLED eyes, buzzer, touch, I2S mic, I2C sensors) with an ESP-NOW
    proximity social layer, offered to colleagues on an adoption day.
    - README, PROJECT_LOG, project CLAUDE.md, licences (MIT code, CC BY-SA 4.0 enclosure)
    - docs: bill of materials, roadmap with prioritised backlog, ADR-0001..0009
    (concept, power roadmap, board, stack, radio, display, sensor tiers, identity,
    licensing), UML study conventions
    - firmware: PlatformIO skeleton on the pinned pioarduino platform (Arduino core
    3.3.x), envs xiao_c3 and c3_supermini (both build), native Unity test (green)
    Co-Author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
    [main.cpp, pins.h]
2026-10-14 ci: add the security CI baseline and the firmware build/test workflow (#1)
    Gitleaks (full history, weekly), CodeQL (actions + c-cpp traced on the native
    host build), dependency review, OSSF Scorecard and Dependabot for GitHub
    Actions, all SHA-pinned; CI workflow running the native unit tests and the
    xiao_c3 / c3_supermini builds; .gitleaks.toml extending the default rules.
    Prerequisite of the public release checklist before the repository goes public.
2026-10-14 docs(architecture): add the first UML study (cube-core, identity, social-presence) (#5)
    * docs(architecture): add the first UML study (cube-core, identity, social-presence)
    Eight Mermaid diagrams under docs/architecture/diagrams/, the contract the V1
    firmware must satisfy (UML-first rule):
    - cube-core: use-case by domain, component (lib logic vs src adapters, eight
    ports), mood engine state, sleep/wake state
    - identity: boot resolves identity, adoption ritual entered by the held-at-boot
    gesture
    - social-presence: presence broadcast with neighbour table and greeting policy,
    data-flow of the 8-byte versioned PRESENCE frame
    Design defaults taken pending the owner's validation are flagg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
2026-10-14 docs: add the design dossier (requirements, use cases, verification plan, gates, hardware specs) (#4)
    * docs: add the design dossier (requirements, use cases, verification, gates, hardware specs)
    Owner decisions ADR-0010 (enclosure as a versioned FreeCAD Python script,
    freecad-mcp for inspection) and ADR-0011 (dossier = arc42-lite + functional
    requirements + Cockburn use cases + traceability matrix + hardware specs with a
    signed GPIO contract + OSHWA assembly guide + PDR/CDR gates; verification =
    committed calculations and ngspice simulations, native tests, golden images,
    bench measurements).
    - docs/architecture/specs/requirements.md, use-cases.md
    - docs/architecture/verification-plan.md,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
2026-10-14 docs(architecture): pass the cube-core PDR (ADR-0013) (#8)
    Four-pass review of the eight diagrams against the requirements, owner
    decisions after scored options: lib-owned PCG32 instead of an IRng port,
    ritual entered from a post-boot invitation window (TTP223 calibrates during
    its first 0.5 s), volume as a second ritual step (V1.x), doze at 10 min and
    sleep at 30 min with any stimulus leaving Tired, REQ-F-11/12/13 deferred to a
    social-group PDR.
    Diagrams amended: use-case numbering unified on the spec (UC2 retired, UC8/UC9
    drawn as deferred, Team actor), MAC passed by value, mood byte computed by the
    codec, tick-driven ritual, touch-down stimulus for the latency budget, sound
    classes and t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
2026-10-15 feat(eyes): brick F1 — ports, Prng, framebuffer and eyes renderer with golden images (#9)
    * test(eyes): red — Prng, Framebuffer and EyesRenderer contracts as native tests
    TDD step one of brick F1 (ADR-0014): tests for the PCG32 generator (determinism,
    streams, bounds, reference value), the 96x64 RGB565 framebuffer (primitives,
    clipping) and the eyes renderer (two eyes in the identity colour, blink
    cadence 2-6 s, blink length, never static for 10 s, closed eyes, brightness,
    burn-in drift, golden images). Vendored stb_image/_write (public domain,
    upstream commit in STB_VERSION) for the golden PNGs.
    * feat(eyes): green — Prng, Fr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
2026-10-15 feat(eyes): brick F1b — reactions overlay and identity frames with a shared Timeline (#10)
    * test(eyes): red — Timeline, reactions overlay and identity frames (brick F1b)
    * feat(eyes): green — Timeline, reactions overlay and identity frames (brick F1b)
    Timeline (start + duration + phase, wrap-safe) now backs the blink, the lid
    move, the reactions and the identity animations. Reactions are an overlay on
    the mood frame that ends on its own (touch-down, surprise, joy, look up, yawn,
    wake, greet) or holds until stopped (purr, soft "^ ^" arcs); blinks are
    deferred during a reaction. Identity frames replace the mood frame: invitatio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
2026-10-15 feat(behaviours): brick F2 — classifiers, mood engine, sleep cycle, sound gate, stimulus router (#12)
    * test(eyes): red — Surprise and Joy blend from the held TouchDown size
    * feat(eyes): Surprise and Joy grow from the held TouchDown size
    A tap shows TouchDown then the classified reaction; the size now blends from the
    touch-down one over two ticks instead of popping twice (open point of the F1b
    review, owner decision 2026-10-15). New golden: touch-to-surprise.
    * test(gesture): red — gesture classifier rows of 05c
    Adds the 05c state diagram (owner decisions: stroke fires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
2026-10-15 feat(social): brick F4 — presence codec, neighbour table, greeting policy (#22)
2026-10-15 feat(firmware): brick F5 — hardware adapters and main.cpp wiring (#26)
    * feat(firmware): brick F5 — hardware adapters and main.cpp wiring
    Seven thin adapters (clock, touch, NVS, buzzer, I2S mic, SSD1331 via
    LovyanGFX 1.2.33, ESP-NOW) and main.cpp boot + 40 ms tick per the
    cube-core component diagram. Owner decisions recorded in 03-component;
    bench checklist in docs/hardware/bench-f5.md.
    * fix(firmware): apply F5 local review — I2S partial reads, init guards, power save
    * fix(firmware): tick the gate first, wake melody at start, defined MAC on read failure
    Co-Authored-By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
    [BuzzerAudio.cpp, BuzzerAudio.h, EspNowRadio.cpp, EspNowRadio.h, I2sMic.cpp, I2sMic.h, MillisClock.h, NvsStorage.h]
2026-10-16 feat(hardware): calculation log, ngspice benches and validation fixes (ADR-0015) (#28)
    * feat(hardware): calculation log, ngspice benches and validation fixes (ADR-0015)
    Apply the V-SEA calculation and simulation method to the cube: append-only
    calculation log C-0001..C-0011 with criticality tiers, ngspice 42 benches with
    worst-case corners and negative controls, tier-3 lines in calc.py.
    Three drafted choices failed and are fixed (owner, scored options):
    - buzzer and I2C SDA swapped so strapping pin GPIO2 reads 1 at reset;
    - display RES# RC 10 kohm / 1 uF + 1N4148 discharge diode;
    - buzzer series resistor 82 ohm (37.2 mA worst case, rating 40 mA).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
    [BuzzerAudio.cpp, calc.py, pins.h]
2026-10-16 feat(hardware): native KiCad schematic, benches fed from its values (#34)
    * feat(hardware): native KiCad schematic, benches fed from its values
    - hardware/electronics/cubbies-v1.kicad_sch + PDF from the GPIO contract (ADR-0015):
    every symbol carries a Justification field (C-NNNN / ADR); ERC clean.
    - I2C expansion port J1: JST-SH 4-pin Qwiic/STEMMA QT (issue #18, owner MCDA 450/500).
    - sim/schematic_values.py exports the SPICE netlist and writes schematic.lib; the four
    benches read R1-R5 and C1 from it, run.sh refreshes it when kicad-cli is present.
    * fix(hardware): address local review on the schematic brick
    Stale calculations R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
    [cubbies-v1.kicad_sch]
2026-10-16 docs(log): stamp the KiCad schematic brick with PR #34 (#35)
2026-10-16 docs(hardware): expansion port design — module budget C-0012, internal bay, plug-and-play (ADR-0016) (#36)
    * docs(hardware): expansion port design — budget C-0012, bay, plug-and-play (ADR-0016)
    Closes the design part of #18: REQ-F-20, REQ-NF-12, UC12, expansion-port UML views,
    traceability and verification rows, C-0012 module budget (50 mA continuous, 75 mA peak),
    internal bay behind a clipped rear cover in the mechanical spec.
    * docs(hardware): address the local review of the expansion port design
    * docs(log): record the expansion port design brick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
2026-10-16 docs(hardware): close CDR paper items — XC6210 LDO, GPIO8 pull-up R6, second method (#30, #31, #32) (#38)
    * docs(hardware): close CDR paper items — XC6210 LDO, GPIO8 pull-up R6, closed-form second method (#30, #31, #32)
    The XIAO ESP32-C3 LDO is a Torex XC6210B332MR, not a TLV75733 (C-0013,
    supersedes C-0002); J1 budget kept provisional until the bench Tj
    measurement. GPIO8 has no pull-up on the XIAO: R6 10k added (C-0014).
    crosscheck.py recomputes every Tier 1 corner without SPICE (C-0015).
    * fix(hardware): carry the XC6210 rail window to every bench, harden the second method
    Review-local findings: buzzer/C-0005/C-0010 corners a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
    [cubbies-v1.kicad_sch]
2026-10-19 feat(case): parametric FreeCAD enclosure script with the module bay (#42) (#43)
    * feat(case): parametric FreeCAD enclosure script with the module bay (#42)
    Front and rear shells with four snap hooks, OLED window and glass recess,
    USB-C opening, mic port, buzzer vent, touch dimple, XIAO rail, ADR-0016
    module bay behind a rear cover clipped by two hooks. The script runs 13
    dimension checks and exports nothing if one fails; STL/STEP/FCStd exports
    are generated artefacts (ADR-0010, CC BY-SA 4.0).
    * refactor(case): model hooks and pockets once and turn them about the y axis
    Cuts the cognitive complexity of shell_hooks from 30 (SonarQube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
    [cubbies-front.stl, cubbies-rear-cover.stl, cubbies-rear.stl, cubbies.FCStd, cubbies.step]
2026-10-19 docs(log): record the FreeCAD enclosure script PR #43 (#44)
2026-10-19 feat(case): print pack with oriented parts, tolerance coupon and 3MF plates (#45) (#46)
    * feat(case): print pack with oriented parts, tolerance coupon and 3MF plates (#45)
    The script now cuts a tolerance coupon from the real shells (one hook, its
    pocket, the cover rebate frame), checks it (18th check), and writes
    print-oriented STLs plus two slicer-neutral 3MF plates to export/print/.
    PRINT.md is the one-page fablab sheet: files, settings from the mechanical
    spec, coupon-first order and what to check.
    Closes #45
    * fix(case): require the whole hook pocket inside the tolerance coupon (#45)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
    [coupon-front.stl, coupon-plate.3mf, coupon-rear.stl, cubbies-front.stl, cubbies-plate.3mf, cubbies-rear-cover.stl, cubbies-rear.stl]
2026-10-19 docs(log): record the fablab print pack PR #46 (#45) (#47)
    * docs(log): record the fablab print pack PR #46 (#45)
    * docs(log): record the electronics benches actually run for PR #46
    ---------
2026-10-22 feat(social): G2 contagious mood — neighbours' moods pull mine (#52) (#54)
    * docs(social): G2 contagion PDR draft — UC8, social-group views, traceability (#52)
    * docs(social): record the owner validation of the G2 contagion PDR (#52)
    * test(social): G2 contagion rows and mood tally, red (#52)
    * feat(social): contagious mood — neighbours' moods pull mine (#52)
    MoodTally filled by the Social protocol, pulledMood() with the priority tie-break, and
    MoodEngine::contagion() with the 6 s hold, calm and 60 s refractory gu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
2026-10-22 feat(social): G3 chain reaction — a double tap ripples through the group (#55) (#56)
    * docs(social): G3 chain reaction conception — UC9, CHAIN frame, sequence and state views (#55)
    * docs(social): record owner validation of the G3 PDR (#55)
    * test(social): failing native tests for the G3 chain reaction rows (#55)
    One test per row of social-group/05b, the CHAIN codec, and the wave over
    LoopbackRadio. Stubs only; red by design (ADR-0014).
    * feat(social): G3 chain reaction — a double tap ripples through the group (#5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
    [main.cpp]
2026-10-23 feat(social): G4 synchronised choir — a stroke starts one melody, one voice per cube (#57) (#58)
    * docs(social): G4 choir conception — UC10, choir sequence and state, CHOIR frame (#57)
    * test(social): G4 choir — failing native tests for every 05c row, CHOIR codec, lead rest (#57)
    * feat(social): G4 synchronised choir — a stroke starts one melody, one voice per cube (#57)
    * docs(log): G4 choir entry, G3 entry points at PR #56, FS8 drift in the verification plan (#57)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
    [main.cpp, test_choir.cpp]
2026-10-23 feat(social): G5 collective sleep — the first yawn spreads (#59) (#60)
    * docs(social): G5 collective sleep conception — REQ-F-20, B4, 02d/05d (#59)
    * test(social): G5 yawn contagion rows of 05d, failing (#59)
    * feat(social): G5 collective sleep — a Bored cube catches a drowsy neighbour's yawn (#59)
    * fix(social): G5 review-local fixes — 05d row 6b, calm test, comments (#59)
    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
2026-10-24 docs(research): voice and AI interaction study, ADR-0017 proposed (#61) (#62)
    * docs(research): voice and AI interaction study, ADR-0017 proposed (#61)
    Research note on keyword spotting (ESP-SR, TFLM on the C3), cloud speech
    through the mother cube, GDPR of an office mic, BOM/power and MicroDuck
    ideas. Owner direction by MCDA: group sound cues first (460/500).
    Roadmap G12 clap wave. Fixes the G5 log entry (PR #60).
    * docs(research): address review-local findings on the voice note (#61)
    * docs(log): reference PR #62 for the voice study (#61)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
2026-11-05 feat(social): G6 jealousy — petting another cube in range makes mine sulk (#75)
    * docs(social): G6 jealousy PDR — REQ-F-21, B5, 05e rows, 02e sequence, PET frame
    * test(social): red tests for G6 jealousy (05e rows, PET codec, Sulk golden)
    * feat(social): G6 jealousy — PET frame, transient sulk, main wiring
    * style(tools): split golden_sheet imports (ruff E401)
    * test(social): address G6 review — real S3 and calm tests, budget reset, docs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
    [main.cpp]
2026-11-05 fix(sonar): turn the quality gate green with Python coverage and two fixes (#81)
    Extract coupon_ok from run_checks (S3776), remove the backtracking in the
    si_value regex (S8786), split the golden_sheet imports (E401), and add
    sonar-project.properties with a coverage script for the bench scripts.
    Closes #53
    [schematic_values.py, test_schematic_values.py]
2026-11-05 docs(adr): ADR-0018 allows bounded one-shot social mood events (#77)
    * docs(adr): ADR-0018 allows bounded one-shot social events
    Amends ADR-0012's "nudge only" consequence: a single frame may trigger a
    one-shot social event, mood included, under seven tested bounds. Needed
    by the G6a jealousy PDR.
    Refs #73
    * docs(log): record ADR-0018
    Refs #73
    * docs(adr): address ADR-0018 review round 1
    Fix the MCDA sums, scope the ADR to mood-changing events, keep
    ADR-0012's no-relay rule untouched, drop the false CHAIN/CHOIR claim and
    mark the amendment as proposed until accepted.
    Refs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
2026-11-05 chore(quality): measure the case script in the SonarQube coverage (#84)
    * refactor(case): split wall probes out of run_checks to clear S3776
    Cognitive complexity of run_checks drops below 15; solid() becomes one
    module-level helper. Regenerated STLs and 3MF members are byte-identical;
    STEP and FCStd differ only by timestamps, UUIDs and object ids.
    Refs #53
    * fix(sim): anchor the spaced-unit regex on a digit to clear S8786
    Same accepted and rejected values; the parser test gains a spaced
    decimal case.
    Refs #53
    * test(sim): fail when the value parser regex backtracks super-li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
    [schematic_values.py, test_schematic_values.py]
2026-11-06 docs(social): G6a jealousy PDR with a context-driven repertoire (#86)
    * docs(social): G6a jealousy PDR with a context-driven repertoire
    Extend the merged G6 Sulk into a two-step crescendo: a silent glance,
    then a step-2 reaction drawn by context weights with a lib-owned Prng.
    Mood unchanged (owner decision D3'); G6 guards and budget kept.
    Supersedes the design of PR #76.
    Refs #85
    * docs(social): address the G6a PDR adversarial review round 1
    Owner attention since the notice, per-guard Noticed outcome, Sulk keeps
    its 900 ms, engine-computed Weary and Neglected (lastOwnerMs_), draw
    rule, presentSince rules and wrap clamp in the neigh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
2026-11-06 test(eyes): G6a face sheet for the seven jealousy reactions (#89)
    * test(eyes): G6a face sheet for the seven jealousy reactions
    Add SideGlance, Stare, TurnAway, Pout, PuppyEyes, MeToo and FakeSleep to
    the eyes renderer, 3 s each per the 05e Repertoire table, with one golden
    per key frame. Sulk keeps 900 ms and its golden. Idle glances are held
    while a reaction plays; Stare suspends the blink then blinks three times,
    pinned by a test.
    * fix(eyes): keep idle glances during held reactions and pin the side rules
    Address the adversarial review of the G6a face sheet: hold glances only
    while a timed reaction plays (a held Purr froze the fr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
2026-11-06 feat(social): G6a jealousy repertoire (crescendo, context weights, seeded draw) (#92)
    * test(social): G6a jealousy repertoire rows of 05e as failing native tests
    Red step (ADR-0014): crescendo, contexts, weights, seeded draw, presentSince,
    petContext, effects mapping and the touch-replaces-reaction renderer row.
    * feat(social): G6a jealousy repertoire (crescendo, context weights, seeded draw)
    Green step for 05e: PetContext and presentSince as input, a two-step
    crescendo in MoodEngine::jealousy, JealousyRepertoire with weight tables,
    no-repeat memory and Prng stream 3, effects(JealousReaction) with three
    rank-2 placeholder sounds. Mo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
    [main.cpp]
2026-11-07 docs(architecture): fix duplicate REQ-F-20, complete the diagram index, align ruff format (#93)
    * docs(architecture): fix duplicate REQ-F-20, complete the diagram index, align ruff format
    Collective sleep becomes REQ-F-22; the README lists every diagram; CI checks ruff format.
    * docs(architecture): address the pre-push review of #87
    Pin ruff-action v4.1.0, document the ruff gate, per-diagram status, REQ-F-22 order.
    * docs(architecture): scope the diagram status line
    * docs(architecture): reflow the diagram status parag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
    [calc.py]
2026-11-07 fix(social): clamp frame receive times to the tick's now (#96)
    * fix(social): clamp frame receive times to the tick's now
    A frame stamped in the Wi-Fi callback after tick() read now aged its
    sender by ~2^32 ms, freeing a greeted neighbour in the same pass and
    re-greeting it. Clamp the receive time in lib/ and test it natively.
    Closes #91
    * test(social): make the #91 test catch a re-greet and cover the wrap
    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
2026-11-07 fix(social): chain frame stamped before startChain meets the row 12 cooldown (#98)
    * fix(social): chain frame stamped before startChain meets the row 12 cooldown
    The cooldown is a symmetric window around the last reaction, so a frame
    queued for another event and stamped just before the origin's trigger
    no longer ages by ~2^32 ms.
    * fix(social): drop a pending chain event on trigger, document the window
    Address the adversarial review: 05b row 12 and its age note describe
    the two-sided cooldown window, start() drops an event heard one tick
    before the trigger, and tests pin the window bound and its wrap.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
2026-11-07 ci(workflows): move every check to local CI and remove the GitHub workflows (#100)
    * ci(workflows): move every check to local CI and remove the GitHub workflows
    Every check now runs on the laptop (skill local-ci, ADR-0019): just fast on
    commit, just check on push (ruff, typos, shellcheck, pio test -e native, both
    board builds, Semgrep on the Python tooling, gitleaks on the history, wiring
    tests), just gate before every merge (check + SonarQube with the quality-gate
    wait, then the signed attestation), just nightly on a systemd user timer
    (TruffleHog, PlatformIO and toolchain pin drift). Tools are pinned in mise.toml
    and mise.lock; lefthook wires the hooks; scripts/attest.sh and just merge
    im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
